Swede-maker/paternoster-filament-storage/pi-agent/paternoster_agent.py

#!/usr/bin/env python3
"""
PAX paternoster — Raspberry Pi GPIO agent.

This program runs ON a Raspberry Pi and drives one paternoster carousel (or a
Left and a Right carousel in twin mode). A carousel is driven by:
  * EITHER one brushed DC motor on a BTS7960 / IBT-2 half-bridge with PWM
    speed control ("dc" drive mode, the default; a timed jog in MILLISECONDS
    nudges the carousel by hand; the second bridge is only used by the Right
    carousel of a twin setup),
  * OR two StepperOnline iSV57T integrated servos on pulse/direction lines,
    one per chain ("servo" drive mode: synchronised dual-motor moves, speed by
    pulse frequency, exact-count micro-jog per motor in PULSES), and
  * two inductive proximity sensors (identical in both modes):
      - SHELF sensor: pulses once as every shelf passes the pick window,
      - INDEX sensor: active only at shelf 1 (the home / absolute reference).

The drive mode is chosen in the web app (setup wizard / Settings) and pushed in
`config.motorMode`; the agent persists it in MOTOR_CONF_PATH and initialises
the matching backend on boot. `--motor dc|servo` overrides it.

It exposes a WebSocket server that the PAX web app connects to. The wire format
matches `lib/node-protocol.ts` in the web app exactly:

  app  -> pi : {"type":"home"} | {"type":"goto","shelf":N} | {"type":"stop"}
               | {"type":"config","shelves":N,"motorMode":"dc|servo",...}
               | {"type":"jog","motor":"a|b|both","direction":"up|down",
                  "pulses":N}            (servo: exact pulse count)
                  "ms":N,"speed":0..1}   (dc: run time in milliseconds)
               | {"type":"release"} | {"type":"hold"}   (servo: free / re-energise)
               | {"type":"hello"}
  pi   -> app: {"type":"hello",...,"motorMode":"dc|servo"} | {"type":"state",...}
               | {"type":"pos","shelf":N} | {"type":"arrived","shelf":N}
               | {"type":"homed","shelf":N} | {"type":"fault","message":"..."}
               | {"type":"servo","mode":"dc|servo","alarmA":bool,"alarmB":bool,
                  "held":bool,"holdTimeoutS":N,...}
                 (drive status; in dc mode the alarm/hold fields are absent)

Shelf indexes are 0-based on the wire (shelf 0 == the INDEX sensor position).

Run on the Pi:
    python3 paternoster_agent.py --name "Paternoster 1" --shelves 9

Test on a laptop (no GPIO hardware needed) with the built-in simulator:
    python3 paternoster_agent.py --simulate --shelves 9
"""

import argparse
import asyncio
import json
import math
import os
import select
import socket
import threading
import time
import traceback
import weakref
from typing import Callable, Optional, Tuple

# Wi-Fi / hotspot management (NetworkManager). Optional: the agent must keep
# driving the motor even if paxnet.py is missing or nmcli is not installed —
# the `net.*` commands then answer with a clear error instead of crashing.
try:
    if __import__("sys").platform == "win32":
        import paxnet_win as paxnet  # noqa: E402  (Windows PC master)
    else:
        import paxnet  # noqa: E402
except Exception as _paxnet_exc:  # pragma: no cover
    paxnet = None
    _PAXNET_IMPORT_ERROR = repr(_paxnet_exc)
else:
    _PAXNET_IMPORT_ERROR = None

# --------------------------------------------------------------------------
# Pin configuration (BCM numbering). Adjust to match your wiring.
# --------------------------------------------------------------------------
# DC drive mode: ONE BTS7960 / IBT-2 43A half-bridge per carousel. Unlike an
# L298N there is no single "enable = PWM" pin: RPWM and LPWM are BOTH PWM
# inputs and *which one* you drive picks the direction. Drive only one at a
# time — driving both together shoots through the bridge.
#
# A single carousel uses bridge A. Bridge B is only used by a twin setup, where
# one Pi drives a Left carousel (motor A) and a Right carousel (motor B), each
# with its own sensors. Two DC motors on the SAME carousel are not supported.
PIN_MOTOR_A_RPWM = 12  # bridge A -> RPWM (PWM, drives one direction)
PIN_MOTOR_A_LPWM = 13  # bridge A -> LPWM (PWM, drives the other direction)
PIN_MOTOR_A_EN = 22    # bridge A -> R_EN + L_EN tied together (HIGH = armed)
PIN_MOTOR_B_RPWM = 20  # bridge B -> RPWM
PIN_MOTOR_B_LPWM = 21  # bridge B -> LPWM
PIN_MOTOR_B_EN = 27    # bridge B -> R_EN + L_EN tied together
# Backwards-compatible aliases (motor_test.py and older notes refer to these).
PIN_MOTOR_RPWM = PIN_MOTOR_A_RPWM
PIN_MOTOR_LPWM = PIN_MOTOR_A_LPWM
PIN_MOTOR_EN = PIN_MOTOR_A_EN
# Kept for the `servo` status snapshot: the "Mirror motor B" switch is shared
# with the servo backend, where it still matters. The DC backend drives one
# motor and does not use it.
DC_MIRROR_B = True
# Timed jog on a DC bridge. There is no step unit, so a jog is "run the motor
# for N milliseconds" at a fixed duty; the app's step size is in ms. The duty
# defaults to the same cruise duty as a move so the motor reliably breaks
# stiction; the app may pass its own `speed`.
DC_JOG_DUTY = 0.45
DC_JOG_MAX_MS = 5000
# Time slice used to poll for an estop while a timed jog runs.
DC_JOG_SLICE_S = 0.01
# Inductive sensor. This is a LEVEL, not a pulse: it stays active for as long as
# a shelf's metal flag is in front of it, and a parked carousel is ALWAYS sitting
# with a flag in the window. So the sensor reads active before a move even starts,
# and that standing signal is not a shelf that has been passed.
#
# Shelves are therefore counted as TRANSITIONS — the flag leaves the window, the
# next flag enters it — never as "one pulse per shelf". Treating the level as a
# pulse is what made a move of N shelves finish after N-1.
PIN_SHELF_SENSOR = 23
PIN_INDEX_SENSOR = 24  # inductive sensor: active only at shelf 1 (home)
# Twin carousels (hardware only): two independent carousels on one Pi. The LEFT
# one uses motor A and the sensors above; the RIGHT one uses motor B and its own
# shelf + home sensors on these pins (wired exactly like 23/24).
PIN_SHELF_SENSOR_R = 19
PIN_INDEX_SENSOR_R = 4
TWIN_SIDES = ("left", "right")

# --------------------------------------------------------------------------
# Servo drive mode: two StepperOnline iSV57T integrated servos on PUL/DIR.
#
# Selected per unit from the app (setup wizard / Settings → "Motor drive") and
# remembered in MOTOR_CONF_PATH so the right backend comes up on the next boot.
# The sensors are identical in both modes; only the motor pins differ.
#
# PUL on GPIO12 / GPIO13: these are the Pi's two hardware-PWM channels, so the
# pulse train is generated by the PWM peripheral and not by a Python loop —
# jitter-free at any frequency the drive accepts. Motor A and motor B get their
# own channel so they can also be jogged INDIVIDUALLY for chain alignment; for
# a move both channels run the same frequency and direction.
#
# The iSV57T opto inputs want 4–5 V at 7–16 mA (manual §3). A Pi GPIO is 3.3 V
# and is only rated for a few mA, so drive PUL/DIR through a 5 V line driver
# (74AHCT125 / 74HCT245) — see README "Servo wiring". ALM is an open-collector
# output: wire ALM- to GND and ALM+ to the GPIO; the Pi's pull-up reads LOW in
# normal operation and HIGH when the drive trips (over-current / over-voltage /
# position-following error).
# --------------------------------------------------------------------------
PIN_SERVO_PUL_A = 12
PIN_SERVO_PUL_B = 13
PIN_SERVO_DIR_A = 5
PIN_SERVO_DIR_B = 6
PIN_SERVO_ALM_A = 16
PIN_SERVO_ALM_B = 26
# "Release" outputs. The iSV57T has NO enable (ENA) input — its control
# connector is only PUL/DIR/ALM — so a parked servo always holds with full
# torque and cannot be turned by hand while powered. The only way to let go is
# to cut the drive's 24–36 V supply. Wire each output to a relay / high-side
# MOSFET module in the +Vdc lead of the matching drive (or tie both outputs to
# one relay that feeds both drives). The agent opens the relay after the idle
# timeout or on request and closes it again before the next move or jog.
# Leave the outputs unconnected if you do not want this; nothing else changes.
PIN_SERVO_ENA_A = 17
PIN_SERVO_ENA_B = 25
# True: GPIO HIGH = relay open = motor free. Set False for a relay module that
# is active-low (most cheap opto relay boards: IN pulled LOW closes the relay).
SERVO_ENA_ACTIVE_RELEASES = True
# Time for the drive to boot after its supply returns before the first pulse
# edge arrives. The iSV57T needs ~1 s after power-up; the step pulses sent
# before that are lost.
SERVO_ENABLE_SETTLE_S = 1.2
# Drives with a real enable input (closed-loop stepper MF, AC servo S-ON) stay
# powered while released, so re-engaging only waits for the coils / servo loop
# to lock, not for a boot.
SERVO_ENA_INPUT_SETTLE_S = 0.3
# Highest pulse rate the Pi header can produce. gpiozero's lgpio pin factory
# (the default on Bookworm / Pi 5) times PWM in software and refuses
# frequencies above 10 kHz. At 800 pulses/rev that is still 750 rpm at the
# motor shaft. The ESP32 controller (hardware LEDC timer) is not capped by this.
SERVO_GPIO_MAX_PPS = 10_000
# Idle seconds before the servos are released automatically. 0 = never release
# (hold with full torque). Defaults to 0 because release only does something
# with the optional supply relay wired. The app overrides this per unit via
# `config.servoHoldTimeoutS`.
SERVO_HOLD_TIMEOUT_S = 0
# Upper bound for the operator's "safe move time" (config.sensorArmS): how long
# after a move or homing run starts the sensors are ignored. 0 = off (default).
SENSOR_ARM_MAX_S = 10.0

# Pulses per motor revolution. Must equal the drive's DIP S1–S3 setting (or
# Pr0.08 when S1–S3 are all OFF). Factory default is 4000 → 0.09° per pulse.
SERVO_PULSES_PER_REV = 4000
# Pulse frequency at 100 % speed. The drive accepts up to 300 kHz, but a
# geared carousel does not need anything close to that: 8 000 pps at 4000 ppr is
# 120 rpm at the motor shaft. The app's "Motor speed" slider scales 0..1 of this.
SERVO_MAX_PPS = 8000
# Lowest frequency the slider floor maps to; below this the carousel just
# twitches between pulses.
SERVO_MIN_PPS = 200
# Idle frequency programmed into the PWM channel while it is switched off.
SERVO_IDLE_HZ = 1000
# Micro-jog pulse rate. Deliberately slow (bit-banged, exact pulse count) so a
# jog of N pulses moves exactly N pulses — this is an ALIGNMENT tool.
SERVO_JOG_PPS = 800
SERVO_JOG_MAX_PULSES = 20000
# Manual §3: DIR must be stable at least 5 µs before the first PUL edge. Python
# cannot sleep 5 µs reliably, so wait 1 ms — invisible to the operator.
SERVO_DIR_SETUP_S = 0.001
# Motor B faces the other way on most dual-chain builds, so its DIR is inverted
# for the two to pull the same way. Flip from the app if yours is wired alike.
SERVO_MIRROR_B = True

# Which drive sits on the PUL/DIR lines. The motion code is identical for all
# three; the profile only decides the polarity of the enable and alarm lines,
# the pulse ceiling and the default pulse source. Mirrors PULSE_DRIVE_PROFILES
# in lib/filament.ts — keep the two in step.
#   ena_active_low : GPIO LOW on the enable output = motor ENGAGED. False
#                    (HIGH = engaged) covers both README hookups: S-ON through
#                    an NPN transistor (HIGH on the base = S-ON conducting =
#                    servo on) and the stepper's MF wired common-anode (+5 V
#                    on MF+, GPIO sinks MF-: LOW = MF conducting = coils OFF,
#                    HIGH = engaged). Flip it from the app if your hookup
#                    inverts one of these (e.g. MF through the transistor).
#   alm_active_low : the ALM optocoupler CONDUCTS (pin LOW) on a fault. iSV57T
#                    and A6-RS conduct while healthy (False); CL86Y conducts
#                    on the alarm (True).
#   has_enable     : the drive has an enable / motor-free input. The iSV57T has
#                    none, so its "release" is the optional supply relay.
PULSE_DRIVE_DEFAULT = "integrated-servo"
PULSE_DRIVES = ("integrated-servo", "ac-servo", "closed-loop-stepper")
PULSE_DRIVE_PROFILES = {
    "integrated-servo":   {"ena_active_low": False, "alm_active_low": False, "max_pps": 300_000, "has_enable": False, "default_driver": "esp32"},
    "ac-servo":           {"ena_active_low": False, "alm_active_low": False, "max_pps": 300_000, "has_enable": True,  "default_driver": "esp32"},
    "closed-loop-stepper":{"ena_active_low": False, "alm_active_low": True,  "max_pps": 200_000, "has_enable": True,  "default_driver": "esp32"},
}


def pulse_drive_profile(drive: Optional[str]) -> dict:
    return PULSE_DRIVE_PROFILES.get(drive if drive in PULSE_DRIVES else PULSE_DRIVE_DEFAULT)

# ESP32 servo controller (pi-agent/esp32-servo). With servoDriver = "esp32" the
# Pi no longer pulses PUL/DIR itself: it sends RUN/STOP/JOG lines to the ESP32
# over a serial link and receives sensor edges and drive status back. The
# sensors move to the ESP32 too, so the stop on a flag never waits for Linux.
#   link "usb"  : the DevKit's micro-USB (CP2102/CH340 -> /dev/ttyUSB0, or
#                 native USB -> /dev/ttyACM0); auto-detected via /dev/serial/by-id.
#   link "uart" : 3 wires on the Pi header (GPIO14 TXD -> ESP32 RX 21,
#                 GPIO15 RXD <- ESP32 TX 22, GND); needs the serial console
#                 disabled (install.sh --esp32-uart does this).
#   link "wifi" : no Pi on that carousel at all. The board runs standalone,
#                 joins the router (or the master's hotspot as a fallback) and
#                 serves the same line protocol on TCP port 8766. This agent
#                 instance is then just the brain for a remote board — run it
#                 on the master Pi as a second service (install.sh --instance).
ESP32_LINK_DEFAULT = "usb"
ESP32_LINKS = ("usb", "uart", "wifi")
ESP32_UART_PORT = "/dev/serial0"
ESP32_USB_CANDIDATES = ("/dev/ttyUSB0", "/dev/ttyACM0", "/dev/ttyUSB1", "/dev/ttyACM1")
ESP32_BAUD_DEFAULT = 460800
ESP32_WIFI_PORT = 8766
ESP32_PING_S = 0.5             # keep-alive; the firmware stops after 1.5 s of silence
ESP32_STATUS_TIMEOUT_S = 1.5   # no status line for this long = link down
ESP32_WIFI_STATUS_TIMEOUT_S = 3.0   # Wi-Fi jitter: give it twice as long (firmware wd_ms matches)
ESP32_RECONNECT_S = 2.0
ESP32_READ_GLITCH_LIMIT = 50   # consecutive empty-read errors (~0.5 s) before the link counts as lost
ESP32_HELLO_TIMEOUT_S = 4.0    # opening a USB port resets the board; it reboots in ~1 s
ESP32_WIFI_CONNECT_TIMEOUT_S = 3.0

# Where the agent remembers the selected drive mode and servo parameters between
# restarts. Written whenever the app pushes a `config` with motor fields.
# A second agent instance on the same Pi (a Wi-Fi ESP32 carousel) gets its own
# file via PAX_MOTOR_CONF / --motor-conf so the two never overwrite each other.
MOTOR_CONF_PATH = os.environ.get("PAX_MOTOR_CONF") or "/var/lib/pax-agent/motor.json"

# Motion tuning. These are DEFAULTS ONLY — the app overrides them at runtime via
# the `config` command, so the speed and soft-start sliders reach the motor. Do
# not read these constants inside motion code; read the Carousel instance fields
# (self.move_speed / self.ramp_pct) or slider changes will silently do nothing.
HOMING_SPEED = 0.35   # 0..1 PWM duty during homing
MOVE_SPEED = 0.45     # 0..1 PWM duty during normal moves
# A BTS7960 with a geared carousel will not break stiction much below this duty;
# it just buzzes and heats. Speed requests are clamped up to this floor.
MIN_DUTY = 0.25
# Floor for an OPERATOR-supplied duty from the app's PWM slider. Much lower than
# MIN_DUTY on purpose: MIN_DUTY protects the agent's own crawls, where a stalled
# motor would break shelf counting, but clamping the slider to it silently
# discarded any lower request and made the control appear dead. Stiction varies
# per machine, so the operator is trusted to find the usable range.
SLIDER_MIN_DUTY = 0.05
# Soft start/stop: seconds spent ramping at 100% ramp intensity. The ramp is
# applied in small PWM steps while the motor is already powered.
MAX_RAMP_SECONDS = 1.2
RAMP_STEP_SECONDS = 0.02  # PWM update interval while ramping
# Hard ceiling on the soft STOP once the target shelf's pulse has been counted.
# Every millisecond of deceleration is extra travel PAST the shelf we were asked
# to stop at, so a full MAX_RAMP_SECONDS soft stop could coast the better part of
# a whole shelf beyond the target. Softness after the target is worth far less
# than stopping where the user asked, so the stop ramp gets its own short budget.
STOP_RAMP_SECONDS = 0.25
# Fraction of the last measured shelf-to-shelf interval that the smooth
# deceleration on the final approach is allowed to occupy. The decel ramp runs
# BEFORE the target flag is detected, across the pitch that already exists
# between the penultimate shelf and the target, so it never adds overshoot — but
# it MUST finish before the flag arrives or the carousel would still be fast at
# the stop. Sizing it to a fraction of the observed pitch guarantees that: the
# final leg starts at cruise and then slows, so it always lasts longer than the
# cruise-speed pitch this fraction is taken from.
DECEL_LEG_FRACTION = 0.6
PULSE_TIMEOUT = 8.0   # seconds to wait for the next shelf pulse before faulting
HOME_TIMEOUT = 30.0   # default seconds to find the index sensor before faulting
# The servo build turns the carousel through a 1:50 gearbox and is a good deal
# slower between flags than the DC build these timeouts were tuned on, so give
# it twice as long before calling a move or a homing run stuck. DC keeps 1x.
SERVO_TIMEOUT_SCALE = 2.0
# The operator can override the homing time per carousel from Settings →
# Motor drive → "Homing time" (config.homeTimeoutS). The drive default is
# HOME_TIMEOUT × the scale above (30 s DC / 60 s servo). Bounds below.
HOME_TIMEOUT_MIN_S = 5.0
HOME_TIMEOUT_MAX_S = 600.0
# Motor drive → "Shelf timeout" (config.shelfTimeoutS). Replaces the
# PULSE_TIMEOUT × drive-scale base of the move's jam guard; speed scaling, ramp
# and Safe move time are still added on top.
SHELF_TIMEOUT_MIN_S = 2.0
SHELF_TIMEOUT_MAX_S = 300.0
# How often a long sensor wait re-checks for an emergency stop. Small enough to
# feel instant to an operator, large enough not to spin the CPU.
ABORT_POLL_SECONDS = 0.02
SENSOR_BOUNCE = 0.01  # debounce (s) for the inductive sensors
# How often the sensor-watch thread samples the shelf sensor's logical level to
# report it to the app. This drives only the UI status lamp — NOT shelf counting
# (that is edge-driven in the motion code) — so a light 20 Hz poll is plenty
# responsive without loading the CPU or perturbing the timing-critical counting.
SENSOR_POLL_SECONDS = 0.05
# ---------------------------------------------------------------------------
# Mechanical shelf-bounce filter.
#
# A shelf can swing/rock as it settles, leaving the sensor window and swinging
# straight back into it. Each re-entry is a fresh rising edge, so the SAME shelf
# was counted twice or more and the carousel believed it had travelled further
# than it had.
#
# The filter is a LOCKOUT APPLIED AFTER a counted shelf: once a shelf is counted,
# further rising edges are ignored for a short period, which is exactly how long
# that shelf's own rocking lasts. The next genuine shelf arrives well after the
# lockout, so it counts.
#
# The direction of the test matters more than its length. An earlier version was
# release-based — an edge only counted once the window had been EMPTY for a while
# first — and that is a precondition IN FRONT OF the stop signal, so the filter
# could delay or drop the very edge that must cut power. It did exactly that on
# every move (see _on_shelf). A lockout can only ever ignore a LATER edge, so the
# rising edge that stops the carousel is always published instantly.
#
# The period is NOT a fixed wall-clock value, because the safe ceiling depends on
# speed. Per-shelf travel is ~0.5s at MOVE_SPEED, so a flat 1.0-1.5s lockout would
# outlast the gap between shelves and swallow genuine ones. Scaling with duty
# keeps it a constant fraction of the real shelf spacing at every speed.
#
# This filters COUNTING only. It never gates motor power, and position still
# comes from counted pulses rather than from elapsed time.
SHELF_SETTLE_AT_MOVE_SPEED = 0.20
SHELF_SETTLE_MAX = 1.5
# ---------------------------------------------------------------------------
# Distance-based shelf-edge filter (Carousel._do_goto).
#
# The time lockout above only knows "how long ago"; it cannot tell a slow swing
# from a slow shelf. A DISTANCE test can. On the servo build the pulse odometer
# says exactly how far the chain has moved since the last counted edge, so an
# edge that arrives inside BOUNCE_PITCH_FRACTION of a shelf pitch is the same
# shelf rocking back into the window, never the next one — regardless of ramp or
# speed. The DC build has no odometer, so it falls back to the same test in TIME,
# against the pitch interval just measured in this move (BOUNCE_TIME_FRACTION,
# deliberately looser because the first interval of a move includes the ramp).
BOUNCE_PITCH_FRACTION = 0.5
BOUNCE_TIME_FRACTION = 0.35
# The FIRST edge of a move. A stop that lands exactly as the flag reaches the
# sensor can leave the shelf a hair short of the window, or rocking back out of
# it; the next move then drags that same flag in and the carousel believes it
# gained a shelf it never travelled. Any edge within this fraction of a pitch of
# the starting point is that parked shelf, not a new one.
START_REENTRY_PITCH_FRACTION = 0.3
# Pulse positioning (servo): deceleration leg before the target as a fraction of
# a shelf pitch, and how often the duty is re-issued along it.
PULSE_DECEL_PITCH_FRACTION = 0.5
PULSE_DUTY_UPDATE_S = 0.02
# The calibration revolution may take a while on a slow chain: allowance for the
# full turn, as a multiple of HOME_TIMEOUT (already drive-scaled).
CALIBRATE_TIMEOUT_SCALE = 3.0
# The index sensor must stay clear this long before the flag counts as passed
# (flag-length measurement), so a flickering edge is not taken for its end.
FLAG_CLEAR_CONFIRM_S = 0.005
# Pause after the second flag pass before reversing onto the flag's middle.
CALIBRATE_REVERSE_SETTLE_S = 0.3


def shelf_settle_for(duty: float) -> float:
    """
    Post-trigger bounce lockout for a given PWM duty.

    Travel time per shelf is inversely proportional to duty, so the lockout scales
    the same way and stays at a constant FRACTION of the real shelf spacing. That
    is what makes one setting correct at 45% and at 5% alike. Capped so a
    near-stalled duty cannot produce an absurdly long blind window.
    """
    lockout = SHELF_SETTLE_AT_MOVE_SPEED * (MOVE_SPEED / max(0.01, duty))
    return min(SHELF_SETTLE_MAX, lockout)


# Travel time for ONE shelf pitch at MOVE_SPEED. Not used to decide position --
# the sensor always does that -- only to say how EARLY an edge has to be before it
# is physically impossible for it to be the next shelf.
SHELF_TRAVEL_AT_MOVE_SPEED = 0.5

# Fraction of a shelf pitch that two accepted shelf counts must be separated by.
#
# The chain can only rock by its own backlash, a fixed mechanical property well
# under one shelf spacing. An edge that appears after less travel than this cannot
# be a new shelf, because the next shelf is a WHOLE pitch away. Kept below 0.5 so
# the rule can never reach halfway to a genuine shelf: if a machine ever has more
# slack than this the cure is to tension the chain, not to widen the window, and
# widening it past 0.5 would start swallowing real shelves.
DEPARTURE_SLACK_FRACTION = 0.45


def min_shelf_gap_for(duty: float) -> float:
    """
    The shortest time in which the carousel could genuinely reach the NEXT shelf.

    Anything sooner is mechanical -- chain slack, a lurch, a flag rocking back
    across the sensor -- and must not be counted. Used ONLY to reject the
    physically impossible, never to decide where the carousel is; the sensor
    always does that.

    Scaled by duty because travel time per pitch is inversely proportional to it,
    so the window stays the same fraction of the real shelf SPACING at every
    speed. That is what makes one constant correct at 45% duty and at 5% alike.

    Two things a single sensor cannot distinguish by level alone, both of which
    produce a real rising edge and both of which were being counted as shelves:

      - THE START OF A MOVE. The carousel is parked on a flag, so energising the
        motor takes up slack: the flag drops back out of the window and is then
        pulled forwards into it again.
      - THE ARRIVAL CHANGEOVER. At one shelf short of target the duty drops to
        the arrival value, and that sudden torque change lets the chain lurch,
        which can carry the shelf just counted back across the sensor.

    Distance travelled is the one thing that separates those from a real shelf.
    """
    pitch = SHELF_TRAVEL_AT_MOVE_SPEED * (MOVE_SPEED / max(0.01, duty))
    return min(SHELF_SETTLE_MAX, DEPARTURE_SLACK_FRACTION * pitch)
# Max time to drive off the index flag when homing starts while already on it.
# The motor runs throughout; this only bounds how long we watch for it to clear.
INDEX_CLEAR_TIMEOUT = 10.0
# Fallback blanking for the rare case where a move STARTS with the shelf window
# already empty (an aborted move, or a fault that left the carousel mid-travel).
# In the normal case the flag is sitting in the window and the far more accurate
# `shelf_clear()` wait below is used instead of this fixed guess.
# The motor runs normally during this window: it filters counting, not power.
# Keep it well under the real per-shelf travel time (~0.5s at MOVE_SPEED).
PULSE_BLANKING = 0.15
# How long to wait for the parked flag to slide back INTO the window when a move
# reverses out of an empty window. Only needs to cover the small overshoot the
# previous stop coasted past the sensor, so it is short. If it expires the flag
# was never there (the machine was left mid-travel), and counting simply starts
# with the next real shelf.
REVERSE_REENTRY_TIMEOUT = 1.5

# ---- Parking ON the sensor -----------------------------------------------
# The carousel parks with the target shelf's flag still INSIDE the sensor
# window, so "in position" is a fact that can be re-checked at any time rather
# than dead reckoning. Two consequences drive the motion code:
#   * A move BEGINS with the sensor already active. The flag must be driven out
#     of the window before counting starts, or the level dropping as it leaves
#     (or a bounce right on the boundary) is counted as the target's arrival and
#     the move ends after ~30mm.
#   * A move must END inside the window. A soft stop always coasts, so after
#     stopping the sensor is re-checked and the shelf is crept back into the
#     window if it drifted out.
# Bounds how long we watch the parked flag leave the window. The motor runs
# throughout; this only limits the wait, exactly like INDEX_CLEAR_TIMEOUT.
SHELF_CLEAR_TIMEOUT = 10.0
# Realignment crawl. MIN_DUTY is the slowest duty that still breaks stiction,
# which is precisely what "go even more slow in reverse" needs.
CREEP_DUTY = MIN_DUTY
CREEP_TIMEOUT = 6.0
# The crawl is PULSED, not continuous: drive for CREEP_PULSE_ON, cut power, let
# it settle for CREEP_PULSE_OFF, then read the sensor. A continuous crawl cannot
# be stopped inside a narrow window — by the time the level is read and `stop()`
# lands, the flag has already coasted out the far side, so the correction
# overshoots in the new direction and the carousel oscillates on one shelf
# forever. Pulsing bounds how far a single step can travel and guarantees the
# sensor is read while the motor is genuinely stopped.
CREEP_PULSE_ON = 0.04
CREEP_PULSE_OFF = 0.05
# How long to wait after cutting power before trusting a sensor reading. Cutting
# power does not stop a loaded carousel; it coasts. Raise this if the machine is
# heavy and alignment decisions still seem to be made on a moving flag.
MOTION_SETTLE = 0.20
# How many verify-and-correct rounds to attempt before declaring the position
# unknown. Bounded on purpose: if the carousel coasts further than the sensor
# window is wide, no amount of retrying can park inside it, and looping forever
# is exactly the "spins back and forth on one shelf" failure. Better to stop and
# ask for a re-home.
SETTLE_ATTEMPTS = 4
# Longest we will wait for a coast to finish before calling the position
# unknown. Must exceed the machine's real coast-down time; a carousel that
# genuinely cannot hold the sensor within this window needs mechanical
# attention (or a lower move speed), not a longer timeout.
COAST_MAX = 3.0
# How long the sensor level must stay unchanged before the carousel is believed
# to be at rest. This must be LONGER than the slowest credible crossing of the
# sensor window, because a machine drifting through the window also holds the
# level steady — just not for long. Too small and a slow coast reads as a park
# (the flag then drifts out and the position silently goes wrong); too large and
# every move pays the wait. It only needs to exceed window_width / creep_speed.
REST_STABLE = 0.9
# Hard cap on ONE correction attempt. Realignment only ever recovers a flag we
# just coasted past, so it should need a fraction of a shelf. Bounding it stops a
# failed correction from turning into an open-ended hunt that parks on a
# different shelf than the one being reported.
CREEP_BUDGET = 1.5
# Hard cap on how many creep pulses one recovery may use. This is the distance
# bound that keeps alignment honest: a recovery that crawls far enough will
# eventually reach the NEXT shelf's flag, pass the "on a flag" test, and report
# the wrong shelf as correct. Sized so the total crawl stays well under one
# shelf pitch. Lower it if a failed alignment ever ends up a shelf out.
CREEP_MAX_PULSES = 12
# Total sensor edges the ENTIRE alignment may pass, across all retries. A single
# attempt being bounded is not enough — several bounded attempts still add up to
# a different shelf. Two is the honest limit: leaving the flag we overshot and
# re-entering it. A third edge means we have entered a DIFFERENT window, and
# anything found there is a different shelf no matter how well centred it is.
SETTLE_MAX_EDGES = 2
# SIMULATION ONLY. Half-width of the sensor window in shelf units, i.e. how much
# of the travel between two shelves reads "detected". A ~35mm flag on a ~200mm
# shelf pitch is about 0.18. Without a window the simulated sensor is a zero-
# width tripwire that is never active while parked, which cannot reproduce any
# of the park-on-sensor behaviour this code exists to get right.
SIM_SENSOR_HALF_WIDTH = 0.18

# Output type of the inductive proximity sensors. This decides which logic level
# counts as "shelf detected", so getting it wrong makes the sensors look dead and
# homing fails with "index sensor not found".
#
#   "NPN" (sinking, active-LOW)  - output floats when idle and pulls to GND when
#                                  triggered. Needs a pull-UP so the pin idles
#                                  high. This is the safe choice for a Pi: the
#                                  signal line only ever sees 3.3 V (from the
#                                  pull-up) or GND, never the sensor's 12/24 V.
#   "PNP" (sourcing, active-HIGH) - output floats when idle and sources +V when
#                                  triggered. Needs a pull-DOWN, AND a level
#                                  shifter/divider, because a 12/24 V sensor
#                                  would otherwise feed 12/24 V straight into a
#                                  3.3 V GPIO and destroy the Pi.
SENSOR_TYPE = "NPN"

# Invert what the sensor signal MEANS, without touching how it is wired.
#
# True  -> a shelf is present when the sensor reads INACTIVE (signal absent).
# False -> a shelf is present when the sensor reads ACTIVE (signal present).
#
# Set this, not SENSOR_TYPE, to fix "it counts in the gaps instead of on the
# shelves". SENSOR_TYPE controls the pull resistor, which is an ELECTRICAL
# property: changing it to flip the logic would leave an NPN line floating, and
# a real PNP sensor needs a level shifter first or it puts 12/24 V into a 3.3 V
# GPIO. This flag is pure logic and is always safe to change.
#
# Use True for a normally-closed sensor, or when the flags are cut as NOTCHES in
# an otherwise continuous ring rather than as tabs — in both cases the signal is
# present everywhere EXCEPT at a shelf, so every edge and level below has to be
# read the other way round.
SENSOR_INVERT = True

# Which way the motor turns for "up" (decreasing shelf index). Flip if your
# carousel runs backwards relative to the app's direction labels.
HOMING_DIRECTION = "down"


def home_travel_direction() -> str:
    """The carousel direction ("up"/"down") the homing sweep runs in."""
    return "up" if HOMING_DIRECTION == "down" else "down"


# ==========================================================================
# Persisted motor-drive selection
# ==========================================================================
def load_motor_conf() -> dict:
    """Read the drive mode + servo tuning saved by a previous `config`."""
    try:
        with open(MOTOR_CONF_PATH, "r", encoding="utf-8") as fh:
            data = json.load(fh)
        return data if isinstance(data, dict) else {}
    except FileNotFoundError:
        return {}
    except Exception as exc:
        print(f"[agent] motor.json unreadable ({exc}); using defaults", flush=True)
        return {}


def save_motor_conf(conf: dict) -> None:
    """
    Persist the drive mode so the next boot initialises the right backend
    before the app has even connected. Best-effort: a read-only filesystem must
    not take the motor down, it just means the mode is re-applied on connect.
    """
    try:
        import os

        os.makedirs(os.path.dirname(MOTOR_CONF_PATH), exist_ok=True)
        tmp = MOTOR_CONF_PATH + ".tmp"
        with open(tmp, "w", encoding="utf-8") as fh:
            json.dump(conf, fh)
        os.replace(tmp, MOTOR_CONF_PATH)
    except Exception as exc:
        print(f"[agent] could not persist motor config ({exc}); will re-apply on next connect", flush=True)


# ==========================================================================
# Hardware backends
# ==========================================================================
def _present(devices) -> tuple:
    """GPIO devices that exist (twin mode leaves the other side's channel None)."""
    return tuple(d for d in devices if d is not None)


class RealHardware:
    """
    Drives real GPIO through gpiozero: ONE DC motor on a BTS7960 bridge plus
    the two inductive sensors. A carousel is driven by a single DC motor; the
    second bridge (motor B) exists only so a twin setup can run a Left and a
    Right carousel from the same Pi, each with its own backend instance.

    The motor half lives in `_init_motor` / `forward` / `backward` / `stop` /
    `_close_motor` / `jog` so `ServoHardware` can swap in PUL/DIR control while
    reusing every sensor-counting detail below unchanged. The motion code only
    ever calls `forward`/`backward`/`stop` with a 0..1 "speed", which the DC
    bridge turns into a PWM duty and a servo drive turns into a pulse frequency.
    """

    motor_mode = "dc"

    def __init__(
        self,
        mirror_b: Optional[bool] = None,
        motor_index: Optional[int] = None,
        shelf_pin: int = PIN_SHELF_SENSOR,
        index_pin: int = PIN_INDEX_SENSOR,
    ) -> None:
        if mirror_b is not None:
            self.mirror_b = bool(mirror_b)
        # Which bridge this carousel's motor is on: 0 = A (default, single
        # carousel or the twin Left side), 1 = B (twin Right side). Only that
        # motor's pins are claimed, so a second backend can own the other one.
        self.motor_index = motor_index if motor_index in (0, 1) else None
        # Run this carousel's motor the other way round.
        self.reverse = False
        self._init_motor()
        self._init_sensor_state()
        self._init_sensors(shelf_pin, index_pin)

    def _init_sensors(self, shelf_pin: int, index_pin: int) -> None:
        """Claim the two sensor GPIOs and route their edges into the counters."""
        from gpiozero import DigitalInputDevice  # imported lazily

        # An NPN (sinking) sensor pulls the line to GND when it detects a shelf,
        # so we pull the pin up and let gpiozero treat LOW as active. A PNP
        # (sourcing) sensor is the mirror image: pull down, HIGH is active.
        # gpiozero derives `is_active` from pull_up, so the rest of this class
        # stays level-agnostic and only this flag has to change.
        pull_up = SENSOR_TYPE.upper() == "NPN"
        self.shelf = DigitalInputDevice(shelf_pin, pull_up=pull_up, bounce_time=SENSOR_BOUNCE)
        self.index = DigitalInputDevice(index_pin, pull_up=pull_up, bounce_time=SENSOR_BOUNCE)
        # WHICH EDGE MEANS "METAL ARRIVED" depends on SENSOR_INVERT.
        #
        # gpiozero names these after the electrical level, not after the shelf. On
        # an inverted sensor the signal is present in the GAPS, so metal arriving
        # DEACTIVATES the input and `when_deactivated` is the arrival edge. Leaving
        # these unswapped is what makes the carousel count in the gaps and stop
        # between shelves — the count would be off by exactly half a pitch.
        if SENSOR_INVERT:
            self.shelf.when_deactivated = self._on_shelf
            self.index.when_deactivated = self._on_index
        else:
            self.shelf.when_activated = self._on_shelf
            self.index.when_activated = self._on_index
        # The exit edge is the opposite one, mirrored the same way — otherwise it
        # would be bound to the same edge as the arrival above and every arrival
        # would immediately register as a departure.
        if SENSOR_INVERT:
            self.shelf.when_activated = self._on_shelf_exit
        else:
            self.shelf.when_deactivated = self._on_shelf_exit

    def _init_sensor_state(self) -> None:
        """Counters, lockout and direction memory shared by every sensor source."""
        # ------------------------------------------------------------------
        # Sensors are EDGE COUNTERS, never a power gate.
        #
        # This class used to answer "has a shelf passed?" with gpiozero's
        # `wait_for_active()`, which returns instantly when the sensor is
        # ALREADY active. A parked carousel sits with a shelf right in the
        # sensor window, so every such call returned True immediately, the
        # move loop burned through all its steps in microseconds, and the
        # motor was switched off again before it could physically turn. The
        # observable result was a motor that only twitched, and that appeared
        # to run only while a sensor saw something.
        #
        # `when_activated` fires ONLY on a real inactive->active transition, so
        # a sensor that is already covered contributes no count at all. Counts
        # accumulate in the background completely independently of motor power:
        # the motion code starts the motor, then consumes counts as they
        # arrive. Sensor LEVEL never decides whether the motor is energised.
        # ------------------------------------------------------------------
        self._lock = threading.Lock()
        self._shelf_pulses = 0
        self._index_pulses = 0
        self._shelf_tick = threading.Event()
        self._index_tick = threading.Event()
        # Mechanical bounce filter state: the time the last shelf was COUNTED.
        # `None` means "no recent count", so the next rising edge passes straight
        # through. See _on_shelf for why this is a lockout AFTER a trigger and
        # never a wait BEFORE one.
        self._last_counted: Optional[float] = None
        self._shelf_settle = 0.0
        self._suppressed_bounces = 0

        # Which way the motor is turning right now, and which way it was turning
        # at the moment the shelf flag LEFT the sensor window.
        #
        # The second is the only reliable answer to "which side of the sensor is
        # the flag parked on", and that is what decides whether the next move
        # will drag it back through. It has to be MEASURED, not inferred from the
        # move direction: depending on how hard the machine brakes, a move can
        # end just PAST the flag (heavy carousel coasts through) or just BEFORE it
        # (the alignment crawl backs out the near side). Those are opposite sides
        # from the same move direction, so assuming either one is wrong half the
        # time. The falling edge is what actually happened.
        self.travel_direction: Optional[str] = None
        self.flag_exit_direction: Optional[str] = None

    def set_shelf_settle(self, seconds: float) -> None:
        """Lockout applied AFTER a counted shelf, to swallow that shelf's bounce."""
        with self._lock:
            self._shelf_settle = max(0.0, seconds)

    def arm_shelf_lockout(self) -> None:
        """
        Start the bounce lockout NOW, without counting a shelf.

        Used when a move starts parked on a flag. That flag is about to be
        dragged out of the window and can rock back into it as the chain takes
        up; arming the lockout makes the hardware treat such a return as the
        bounce it is. Without this the first edge of every move was accepted
        unconditionally, because `reset_pulses` had just cleared the lockout.
        """
        with self._lock:
            self._last_counted = time.monotonic()

    def _on_shelf_exit(self) -> None:
        if self.travel_direction is not None:
            self.flag_exit_direction = self.travel_direction

    def _on_shelf(self) -> None:
        """
        RISING EDGE. Untriggered -> triggered. This is the event the whole machine
        stops on, so it is published IMMEDIATELY and unconditionally, unless it is
        a re-trigger of the shelf that was just counted.

        The bounce filter is a LOCKOUT AFTER a counted shelf, never a wait BEFORE
        one. That distinction is the entire bug that made the carousel drive past
        its target:

        This used to be release-based — an edge only counted if the window had
        been EMPTY for `settle` first. That puts a precondition in front of the
        stop signal, so the filter could DELAY or DROP the very edge that must cut
        power. It reliably did: on the last shelf the move drops to the slower
        `approach` duty, `settle` is recomputed for that slow duty (0.40s) while
        the carousel is still physically coasting near cruise (real gap 0.25s), so
        the target's arrival edge was swallowed every time and the loop ran on to
        the NEXT shelf. It also failed outright whenever the metal flag covered
        more than ~60% of the shelf pitch, because then the empty gap is shorter
        than the settle at any speed.

        A lockout cannot do that. The first edge after a reset always passes with
        zero delay, so trigger -> stop is exact; only the SAME shelf rocking back
        into the window inside the lockout is ignored.
        """
        now = time.monotonic()
        with self._lock:
            last = self._last_counted
            lockout = self._shelf_settle
            if last is not None and lockout > 0 and (now - last) < lockout:
                # Same shelf rocking in the window again, not the next shelf.
                self._suppressed_bounces += 1
                return
            self._last_counted = now
            self._shelf_pulses += 1
        self._shelf_tick.set()

    def _on_index(self) -> None:
        with self._lock:
            self._index_pulses += 1
        self._index_tick.set()

    # ---- motor backend (DC / one BTS7960 bridge) ----------------------------
    # `mirror_b` is read through `getattr` so a subclass that does not set it
    # (ServoHardware has its own) still constructs cleanly. The DC backend
    # drives one motor, so it only stores the flag for the `servo` snapshot.
    mirror_b: bool = DC_MIRROR_B

    def _channel(self) -> int:
        """The bridge index this carousel's motor is on: A unless twin Right."""
        mi = getattr(self, "motor_index", None)
        return mi if mi in (0, 1) else 0

    def _init_motor(self) -> None:
        from gpiozero import Motor, DigitalOutputDevice

        # BTS7960: passing NO `enable` to Motor makes gpiozero PWM the two
        # direction pins directly, which is exactly what RPWM/LPWM want — it
        # drives one pin with the duty cycle and holds the other at 0.
        # Index 0 is motor A, index 1 is motor B. Only the owned bridge is
        # claimed; the other one's pins stay free for a twin backend.
        pins = (
            (PIN_MOTOR_A_RPWM, PIN_MOTOR_A_LPWM, PIN_MOTOR_A_EN),
            (PIN_MOTOR_B_RPWM, PIN_MOTOR_B_LPWM, PIN_MOTOR_B_EN),
        )
        rpwm, lpwm, en = pins[self._channel()]
        self.motor = Motor(forward=rpwm, backward=lpwm, pwm=True)
        # R_EN and L_EN of the bridge tied to one GPIO: HIGH arms the bridge,
        # LOW makes the outputs float. Pulling this LOW is a true hardware stop
        # that works even if a PWM pin is stuck, so the estop path uses it.
        self.enable = DigitalOutputDevice(en, initial_value=True)
        self._motor_lock = threading.Lock()
        self._jog_abort = False

    def _drive(self, forward: bool, speed: float) -> None:
        """Run the bridge in the carousel's `forward` sense, honouring Reverse."""
        bridge_forward = forward != bool(getattr(self, "reverse", False))
        duty = max(0.0, min(1.0, float(speed)))
        self.enable.on()  # re-arm in case an estop left the bridge disabled
        if bridge_forward:
            self.motor.forward(duty)
        else:
            self.motor.backward(duty)

    def forward(self, speed: float) -> None:
        with self._motor_lock:
            self._drive(True, speed)

    def backward(self, speed: float) -> None:
        with self._motor_lock:
            self._drive(False, speed)

    def stop(self) -> None:
        # Zero the PWM first so the bridge brakes cleanly, then disarm it. Doing
        # it in this order avoids floating the outputs while a duty cycle is
        # still applied.
        with self._motor_lock:
            self.motor.stop()
            self.enable.off()

    def _close_motor(self) -> None:
        self.stop()  # leave the bridge disarmed on exit
        self.motor.close()
        self.enable.close()

    def jog(self, motor: str, direction: str, amount: int, speed: Optional[float] = None) -> None:
        """
        Timed jog: run the carousel's motor in `direction` for `amount`
        MILLISECONDS at a fixed duty. This is the DC equivalent of the servo's
        pulse-count jog. `motor` is accepted for protocol compatibility but a
        DC carousel has only one motor, so it is ignored. It blocks on the
        Carousel worker; `abort_jog()` (estop) cuts it short within one
        DC_JOG_SLICE_S.
        """
        ms = max(0, min(DC_JOG_MAX_MS, int(amount)))
        if ms == 0:
            return
        duty = DC_JOG_DUTY if speed is None else max(SLIDER_MIN_DUTY, min(1.0, float(speed)))
        # Same convention as Carousel._energise: "down" is the bridge's forward.
        forward = direction == "down"
        self._jog_abort = False
        with self._motor_lock:
            self._drive(forward, duty)
        deadline = time.monotonic() + ms / 1000.0
        try:
            while time.monotonic() < deadline:
                if self._jog_abort:
                    break
                time.sleep(min(DC_JOG_SLICE_S, max(0.0, deadline - time.monotonic())))
        finally:
            self.stop()

    def abort_jog(self) -> None:
        self._jog_abort = True

    def set_servo_params(self, mirror_b=None, **_: object) -> None:
        """
        Drive tuning from the app's `config`. Pulses/rate are servo-only and
        ignored; `mirror_b` is only remembered for the status snapshot.
        """
        if mirror_b is not None:
            self.mirror_b = bool(mirror_b)

    def servo_snapshot(self) -> Optional[dict]:
        """
        Drive status (`servo` event on the wire, kept for compatibility). In DC
        mode it tells the app which backend is live; there are no alarm lines
        on a BTS7960, so those fields are absent.
        """
        return {
            "type": "servo",
            "mode": "dc",
            "mirrorB": self.mirror_b,
            "jogMaxMs": DC_JOG_MAX_MS,
        }

    def reset_pulses(self) -> None:
        """Drop stale counts. Call before a move; never touches motor power."""
        with self._lock:
            self._shelf_pulses = 0
            self._index_pulses = 0
            # Clear the bounce lockout too. A move ends by stopping ON a flag, so
            # `_last_counted` is only milliseconds old when the next move starts.
            # Leaving it set would make the lockout suppress the NEXT move's first
            # genuine arrival — reintroducing the drive-past-the-target bug at the
            # start of every move instead of the end.
            self._last_counted = None
        self._shelf_tick.clear()
        self._index_tick.clear()

    def _take(self, kind: str, timeout: float) -> bool:
        """
        Consume one counted pulse, waiting up to `timeout` for one to arrive.
        The counter is the source of truth and the Event is only a wake-up
        hint, so a pulse landing between the check and the clear is still
        counted rather than lost.
        """
        tick = self._shelf_tick if kind == "shelf" else self._index_tick
        deadline = time.monotonic() + timeout
        while True:
            with self._lock:
                if kind == "shelf" and self._shelf_pulses > 0:
                    self._shelf_pulses -= 1
                    return True
                if kind == "index" and self._index_pulses > 0:
                    self._index_pulses -= 1
                    return True
            remaining = deadline - time.monotonic()
            if remaining <= 0:
                return False
            tick.clear()
            tick.wait(min(remaining, 0.05))

    def take_shelf_pulse(self, timeout: float) -> bool:
        return self._take("shelf", timeout)

    def take_index_pulse(self, timeout: float) -> bool:
        return self._take("index", timeout)

    def index_clear(self, timeout: float) -> bool:
        """
        Block until the index window is EMPTY, leaving motor power untouched so
        the carousel keeps driving off the flag while we watch.
        """
        deadline = time.monotonic() + timeout
        while self._index_level():
            if time.monotonic() >= deadline:
                return False
            time.sleep(0.005)
        return True

    # Every level read in this class goes through these two helpers, so the
    # inversion is applied in exactly one place per sensor and cannot drift
    # between the "is metal there now" checks and the "wait until it is gone"
    # loops. Reading `.is_active` directly anywhere below would bypass it.
    def _shelf_level(self) -> bool:
        """True when a shelf flag is in front of the sensor."""
        raw = bool(self.shelf.is_active)
        return (not raw) if SENSOR_INVERT else raw

    def _index_level(self) -> bool:
        """True when the home flag is in front of the sensor."""
        raw = bool(self.index.is_active)
        return (not raw) if SENSOR_INVERT else raw

    def index_active(self) -> bool:
        return self._index_level()

    def shelf_clear(self, timeout: float) -> bool:
        """
        Block until the shelf window is EMPTY, leaving motor power untouched so
        the carousel keeps driving off the flag while we watch.

        This is the counterpart to `index_clear` for the per-shelf sensor, and it
        is what makes parking ON the sensor safe: the level is only consulted to
        decide when COUNTING may begin, never whether the motor is energised.
        """
        deadline = time.monotonic() + timeout
        while self._shelf_level():
            if time.monotonic() >= deadline:
                return False
            time.sleep(0.005)
        return True

    def shelf_active(self) -> bool:
        return self._shelf_level()

    def in_shelf_lockout(self) -> bool:
        """
        True while metal in the window still belongs to the shelf just counted.

        The interrupt path applies this lockout in `_on_shelf`, but the counting
        loop ALSO detects shelves by polling `shelf_active()`, and that path had
        no lockout at all. So a flag rocking back into the window was rejected as
        a bounce on one path and accepted as a new shelf on the other -- which is
        how the lurch at the arrival changeover got counted and every multi-shelf
        move finished one shelf early. Exposing the same state lets the poll path
        honour the same decision instead of contradicting it.
        """
        with self._lock:
            last = self._last_counted
            lockout = self._shelf_settle
            if last is None or lockout <= 0:
                return False
            return (time.monotonic() - last) < lockout

    def cleanup(self) -> None:
        try:
            self._close_motor()
            self.shelf.close()
            self.index.close()
        except Exception:
            pass


class ServoHardware(RealHardware):
    """
    Two iSV57T integrated servos driven by pulse (PUL) and direction (DIR).

    Sensors, shelf counting and the lockout logic are inherited unchanged from
    RealHardware; only the motor half is replaced:

      * `forward`/`backward(speed)` set both DIR lines and start a continuous
        50 % duty pulse train on both PUL lines at `speed × max_pps` Hz. The
        drive runs in position mode (Pr0.01 = 0) and follows the pulse stream,
        so velocity control IS pulse-frequency control. Both channels carry the
        same frequency and direction, so the two motors stay synchronised.
      * `stop()` zeroes the duty: the PUL line goes low and the servo holds its
        last position with full torque. A stopped servo therefore brakes far
        harder than a coasting DC motor, which is why servo users see less
        overshoot and can usually run a faster approach.
      * `release()` / `engage()` drive the ENA inputs. Released, the motors are
        de-energised and the carousel can be turned by hand; the Carousel
        releases them after an idle timeout and every move/jog re-engages them
        first (with a short settle so no pulses are lost).
      * `jog(motor, direction, pulses)` bit-bangs an exact number of pulses to
        ONE motor (or both) at a slow rate. This is the alignment tool: if the
        two chains drift, nudge one side until the shelf hangs level.
    """

    motor_mode = "servo"

    def __init__(
        self,
        pulses_per_rev: int = SERVO_PULSES_PER_REV,
        max_pps: int = SERVO_MAX_PPS,
        mirror_b: bool = SERVO_MIRROR_B,
        ignore_alarm: bool = False,
        single_motor: bool = False,
        motor_index: Optional[int] = None,
        shelf_pin: int = PIN_SHELF_SENSOR,
        index_pin: int = PIN_INDEX_SENSOR,
        pulse_drive: str = PULSE_DRIVE_DEFAULT,
        ena_active_low: Optional[bool] = None,
        alm_active_low: Optional[bool] = None,
    ) -> None:
        # Drive profile first: it caps max_pps and sets the line polarities.
        self.pulse_drive = pulse_drive if pulse_drive in PULSE_DRIVES else PULSE_DRIVE_DEFAULT
        prof = pulse_drive_profile(self.pulse_drive)
        self.ena_active_low = bool(prof["ena_active_low"] if ena_active_low is None else ena_active_low)
        self.alm_active_low = bool(prof["alm_active_low"] if alm_active_low is None else alm_active_low)
        self.has_enable_input = bool(prof["has_enable"])
        self.drive_max_pps = int(prof["max_pps"])
        self.pulses_per_rev = max(1, int(pulses_per_rev))
        self.max_pps = max(SERVO_MIN_PPS, min(self._pps_ceiling(), int(max_pps)))
        self.mirror_b = bool(mirror_b)
        # One-servo hardware carousel: only channel A is pulsed and monitored.
        self.single_motor = bool(single_motor)
        # ALM has a pull-up, so an UNWIRED ALM pin reads exactly like a tripped
        # drive. Builds without ALM+/ALM- connected set this to run anyway.
        self.ignore_alarm = bool(ignore_alarm)
        super().__init__(motor_index=motor_index, shelf_pin=shelf_pin, index_pin=index_pin)

    # Hardware-style stop on a sensor edge, the Pi-header twin of the ESP32's
    # ARM command. Class defaults so subclasses that skip _init_motor (the
    # ESP32 backend) see a disarmed state and the callbacks stay pass-through.
    _gpio_arm: Optional[str] = None
    _gpio_arm_ready = False
    _gpio_arm_gap_s = 0.0
    _gpio_off_since = {"shelf": 0.0, "index": 0.0}
    _jog_abort = False

    def _pps_ceiling(self) -> int:
        """Highest pulse rate this controller can produce for the drive."""
        return min(self.drive_max_pps, SERVO_GPIO_MAX_PPS)

    def _init_sensors(self, shelf_pin: int, index_pin: int) -> None:
        super()._init_sensors(shelf_pin, index_pin)
        self._gpio_off_since = {"shelf": time.monotonic(), "index": time.monotonic()}
        # The base class only binds the index ARRIVAL edge; the arm needs the
        # departure too, to know how long the window has been empty.
        if SENSOR_INVERT:
            self.index.when_activated = self._on_index_exit
        else:
            self.index.when_deactivated = self._on_index_exit

    def _arm_left(self, sensor: str) -> None:
        self._gpio_off_since = {**self._gpio_off_since, sensor: time.monotonic()}
        if self._gpio_arm == sensor:
            self._gpio_arm_ready = True

    def _arm_arrived(self, sensor: str) -> None:
        """Mirror of the firmware's armCheck(): cut the train on the armed arrival."""
        if self._gpio_arm != sensor or not self._gpio_arm_ready:
            return
        if time.monotonic() - self._gpio_off_since.get(sensor, 0.0) < self._gpio_arm_gap_s:
            # A flag rocking back into the window: wait for a real departure.
            self._gpio_arm_ready = False
            return
        self._gpio_arm = None
        # Straight from the GPIO callback thread: PUL goes low now, before the
        # Carousel worker even sees the edge. Like the ESP32 this is not a latch;
        # the next forward()/backward() starts the train again.
        self.stop()

    def _on_shelf_exit(self) -> None:
        super()._on_shelf_exit()
        self._arm_left("shelf")

    def _on_index_exit(self) -> None:
        self._arm_left("index")

    def _on_shelf(self) -> None:
        self._arm_arrived("shelf")
        super()._on_shelf()

    def _on_index(self) -> None:
        self._arm_arrived("index")
        super()._on_index()

    def arm_stop(self, sensor: str = "shelf", min_gap_s: float = 0.0) -> None:
        """
        Stop the pulse train on the next ARRIVAL edge of `sensor` ("shelf" or
        "index") from the sensor callback itself, the same contract as the
        ESP32 backend: the edge still reaches the counters, only the stop
        happens earlier. `min_gap_s` = how long the window must have been empty.
        """
        sensor = "index" if sensor == "index" else "shelf"
        level = self._index_level() if sensor == "index" else self._shelf_level()
        self._gpio_arm_gap_s = max(0.0, float(min_gap_s))
        # Ready only once the window has been seen empty since arming.
        self._gpio_arm_ready = not level
        self._gpio_arm = sensor

    def disarm(self) -> None:
        self._gpio_arm = None

    def abort_jog(self) -> None:
        """Cut a running jog between two pulses (estop / Stop button)."""
        self._jog_abort = True

    def _channels(self) -> tuple:
        """Servo channels this backend owns: both, or just its twin-side one."""
        mi = getattr(self, "motor_index", None)
        return (mi,) if mi in (0, 1) else (0, 1)

    def _init_motor(self) -> None:
        from gpiozero import PWMOutputDevice, DigitalOutputDevice, DigitalInputDevice

        # Twin mode claims only this side's channel; the other stays None so the
        # second backend on the same Pi can own those pins.
        owned = self._channels()

        def pair(make_a, make_b):
            return (make_a() if 0 in owned else None, make_b() if 1 in owned else None)

        self.pul = pair(
            lambda: PWMOutputDevice(PIN_SERVO_PUL_A, frequency=SERVO_IDLE_HZ, initial_value=0),
            lambda: PWMOutputDevice(PIN_SERVO_PUL_B, frequency=SERVO_IDLE_HZ, initial_value=0),
        )
        self.dir = pair(
            lambda: DigitalOutputDevice(PIN_SERVO_DIR_A, initial_value=False),
            lambda: DigitalOutputDevice(PIN_SERVO_DIR_B, initial_value=False),
        )
        # ALM is an opto-isolated open-collector output that CONDUCTS in normal
        # operation and goes high-impedance on a fault. With the Pi's pull-up,
        # gpiozero's `is_active` (pin LOW) therefore means "healthy".
        self.alm = pair(
            lambda: DigitalInputDevice(PIN_SERVO_ALM_A, pull_up=True, bounce_time=0.05),
            lambda: DigitalInputDevice(PIN_SERVO_ALM_B, pull_up=True, bounce_time=0.05),
        )
        # Start ENGAGED (holding) so power-up matches the drive's own default.
        # `active_high` folds the polarity in: `.on()` always means "release".
        # Integrated servos have no enable input, so GPIO 17/25 drive the
        # optional supply relay (SERVO_ENA_ACTIVE_RELEASES). AC servos and
        # closed-loop steppers have one (S-ON / MF): "engaged" is GPIO HIGH
        # unless the profile / app says the line is active-low, so "release"
        # (.on()) is the opposite level.
        release_is_high = (not self.has_enable_input and SERVO_ENA_ACTIVE_RELEASES) or (self.has_enable_input and self.ena_active_low)
        self.ena = pair(
            lambda: DigitalOutputDevice(PIN_SERVO_ENA_A, active_high=release_is_high, initial_value=False),
            lambda: DigitalOutputDevice(PIN_SERVO_ENA_B, active_high=release_is_high, initial_value=False),
        )
        self._held = True
        self._motor_lock = threading.Lock()
        self._pulsing = False
        self._forward: Optional[bool] = None
        # Pulse ODOMETER. The pulse train is a PWM carrier at a set frequency,
        # so nothing counts the individual pulses; instead every segment of
        # constant frequency is integrated (hz × seconds, signed by direction)
        # the moment it ends. The drive steps once per pulse, so this IS the
        # commanded position, good to well under a percent — and the index flag
        # re-syncs the remainder on every pass (see Carousel._do_goto_pulses).
        self._odo_lock = threading.Lock()
        self._odo_pulses = 0.0
        self._odo_hz = 0
        self._odo_sign = 0
        self._odo_t0 = time.monotonic()

    def _odo_close_segment(self) -> None:
        """Bank the segment that is ending. Caller holds `_odo_lock`."""
        now = time.monotonic()
        if self._odo_hz > 0 and self._odo_sign != 0:
            self._odo_pulses += self._odo_sign * self._odo_hz * (now - self._odo_t0)
        self._odo_t0 = now

    def _odo_segment(self, hz: int, sign: int) -> None:
        """Start a new constant-frequency segment (hz=0 or sign=0 = stopped)."""
        with self._odo_lock:
            self._odo_close_segment()
            self._odo_hz = hz
            self._odo_sign = sign

    def pulse_position(self) -> float:
        """Signed pulses sent since start-up: forward() counts up, backward() down."""
        with self._odo_lock:
            self._odo_close_segment()
            return self._odo_pulses

    def pulse_rate(self, speed: float) -> float:
        """Pulses per second the carrier runs at for a 0..1 speed."""
        return float(self._hz_for(speed))

    @property
    def held(self) -> bool:
        """True while the servos are energised and holding position."""
        return self._held

    def engage(self) -> None:
        """Re-energise both servos. Blocks for the settle time if they were released."""
        with self._motor_lock:
            if self._held:
                return
            for e in _present(self.ena):
                e.off()
            time.sleep(SERVO_ENA_INPUT_SETTLE_S if self.has_enable_input else SERVO_ENABLE_SETTLE_S)
            self._held = True

    def release(self) -> None:
        """De-energise both servos so the carousel can be moved by hand."""
        with self._motor_lock:
            self._gpio_arm = None
            self._odo_segment(0, 0)
            for p in _present(self.pul):
                p.value = 0
            self._pulsing = False
            for e in _present(self.ena):
                e.on()
            self._held = False

    # The motion code's "forward"/"backward" map onto DIR levels here. Motor B
    # is mirrored when the two servos face each other across the carousel.
    def _dir_levels(self, forward: bool) -> tuple[bool, bool]:
        if self.motor_index is not None:
            level = forward != bool(getattr(self, "reverse", False))
            return level, level
        a = forward
        b = (not forward) if self.mirror_b else forward
        return a, b

    def _hz_for(self, speed: float) -> int:
        speed = max(0.0, min(1.0, float(speed)))
        return max(SERVO_MIN_PPS, int(round(speed * self.max_pps)))

    def _active_pul(self) -> tuple:
        """PUL outputs that drive the carousel: A only on a one-servo build."""
        if self.motor_index is not None:
            return _present(self.pul)
        return self.pul[:1] if self.single_motor else self.pul

    def _set_dir(self, forward: bool) -> None:
        a, b = self._dir_levels(forward)
        if self.dir[0] is not None:
            self.dir[0].value = a
        if self.dir[1] is not None:
            self.dir[1].value = b

    def _run_pulses(self, forward: bool, speed: float) -> None:
        self.engage()
        with self._motor_lock:
            hz = self._hz_for(speed)
            if not self._pulsing or self._forward != forward:
                # Never flip DIR under a running pulse train: stop, set the
                # direction, give it the setup time the drive asks for, resume.
                self._odo_segment(0, 0)
                for p in _present(self.pul):
                    p.value = 0
                self._set_dir(forward)
                time.sleep(SERVO_DIR_SETUP_S)
            for p in self._active_pul():
                p.frequency = hz
            for p in self._active_pul():
                p.value = 0.5
            self._odo_segment(hz, 1 if forward else -1)
            self._pulsing = True
            self._forward = forward

    def forward(self, speed: float) -> None:
        self._run_pulses(True, speed)

    def backward(self, speed: float) -> None:
        self._run_pulses(False, speed)

    def stop(self) -> None:
        with self._motor_lock:
            self._odo_segment(0, 0)
            for p in _present(self.pul):
                p.value = 0
            self._pulsing = False

    def _close_motor(self) -> None:
        self.stop()
        # Leave the drives in their power-up (enabled) state, not released.
        for e in _present(self.ena):
            e.off()
        for dev in _present((*self.pul, *self.dir, *self.alm, *self.ena)):
            dev.close()

    def jog(self, motor: str, direction: str, amount: int, speed: Optional[float] = None) -> None:
        """
        Send exactly `amount` pulses to motor "a", "b" or "both" in `direction`
        ("up"/"down", the same words the move logic uses). `speed` is accepted
        for signature parity with the DC backend and ignored: the jog rate is
        fixed so the pulse count stays exact. Blocking; runs on the Carousel
        worker so an estop (`stop()` + abort) can cut it short only between
        pulses — a few hundred microseconds.
        """
        pulses = max(0, min(SERVO_JOG_MAX_PULSES, int(amount)))
        if pulses == 0:
            return
        if self.motor_index is not None:
            # Twin side: its one servo IS this carousel's drive.
            motor = "both"
            targets = (self.motor_index,)
        elif self.single_motor:
            # The one servo IS the carousel drive: any jog moves the carousel,
            # and channel B has nothing connected.
            if motor == "b":
                return
            motor = "both"
            targets = (0,)
        else:
            targets = (0, 1) if motor == "both" else ((0,) if motor == "a" else (1,))
        self.engage()
        # Same convention as Carousel._energise: "down" is the bridge's forward.
        forward = direction == "down"
        half = 0.5 / SERVO_JOG_PPS
        with self._motor_lock:
            self._odo_segment(0, 0)
            for p in _present(self.pul):
                p.value = 0
            self._pulsing = False
            self._set_dir(forward)
            time.sleep(SERVO_DIR_SETUP_S)
            self._jog_abort = False
            sent = 0
            for _ in range(pulses):
                if self._jog_abort:
                    break
                for i in targets:
                    self.pul[i].value = 1
                time.sleep(half)
                for i in targets:
                    self.pul[i].value = 0
                time.sleep(half)
                sent += 1
            # Only a jog of BOTH chains moves the carousel; nudging one side
            # levels a shelf without changing where the carousel is.
            if motor == "both" and sent:
                with self._odo_lock:
                    self._odo_close_segment()
                    self._odo_pulses += (1 if forward else -1) * sent

    def set_servo_params(
        self,
        pulses_per_rev=None,
        max_pps=None,
        mirror_b=None,
        ignore_alarm=None,
        single_motor=None,
        **_: object,
    ) -> None:
        if pulses_per_rev is not None:
            self.pulses_per_rev = max(1, int(pulses_per_rev))
        if max_pps is not None:
            self.max_pps = max(SERVO_MIN_PPS, min(self._pps_ceiling(), int(max_pps)))
        if mirror_b is not None:
            self.mirror_b = bool(mirror_b)
        if ignore_alarm is not None:
            self.ignore_alarm = bool(ignore_alarm)
        if single_motor is not None:
            with self._motor_lock:
                self.single_motor = bool(single_motor)
                if self.single_motor and self.motor_index is None and self.pul[1] is not None:
                    self.pul[1].value = 0

    def _alm_tripped(self, dev) -> bool:
        """Read one ALM input in the drive's polarity (pull-up: is_active = pin LOW)."""
        # Conducts-while-healthy drives (iSV57T, A6-RS): LOW = fine, open = fault.
        # Conducts-on-fault drives (CL86Y): LOW = fault, open = fine.
        return bool(dev.is_active) if self.alm_active_low else not dev.is_active

    def alarms(self) -> tuple[bool, bool]:
        """(motor A alarm, motor B alarm) — True when the drive has tripped."""
        if self.ignore_alarm:
            return (False, False)
        # An unused channel has no drive on its ALM, so its pull-up would read
        # as a permanent fault; unowned / one-servo channels never report.
        a = self.alm[0] is not None and self._alm_tripped(self.alm[0])
        b_used = self.alm[1] is not None and not (self.single_motor and self.motor_index is None)
        b = b_used and self._alm_tripped(self.alm[1])
        return (a, b)

    def servo_snapshot(self) -> Optional[dict]:
        a, b = self.alarms()
        return {
            "type": "servo",
            "mode": "servo",
            "alarmA": a,
            "alarmB": b,
            "ignoreAlarm": self.ignore_alarm,
            "pulsesPerRev": self.pulses_per_rev,
            "maxPps": self.max_pps,
            "mirrorB": self.mirror_b,
            "singleMotor": self.single_motor,
            "held": self._held,
            "pulseDrive": self.pulse_drive,
            "enableActiveLow": self.ena_active_low,
            "alarmActiveLow": self.alm_active_low,
        }


class _TcpLink:
    """
    Just enough of pyserial's Serial surface (read / in_waiting / write /
    close) over a TCP socket, so the ESP32 backend runs unchanged whether the
    board hangs off a USB cable or sits on the other side of the hall on Wi-Fi.
    """

    def __init__(self, sock) -> None:
        self._sock = sock
        sock.settimeout(0.05)
        try:
            sock.setsockopt(socket.IPPROTO_TCP, socket.TCP_NODELAY, 1)
        except OSError:
            pass

    @property
    def in_waiting(self) -> int:
        r, _, _ = select.select([self._sock], [], [], 0)
        return 4096 if r else 0

    def read(self, n: int = 1) -> bytes:
        try:
            data = self._sock.recv(max(1, n))
        except socket.timeout:
            return b""
        if not data:
            raise ConnectionError("peer closed the link")
        return data

    def write(self, data: bytes) -> int:
        self._sock.sendall(data)
        return len(data)

    def close(self) -> None:
        try:
            self._sock.shutdown(socket.SHUT_RDWR)
        except OSError:
            pass
        self._sock.close()


# Every live ESP32 backend, so the networking layer can hand new Wi-Fi
# credentials to standalone boards without holding a reference to the motor.
_ESP32_LINKS: "weakref.WeakSet" = weakref.WeakSet()


def esp32_wifi_links() -> list:
    return [h for h in list(_ESP32_LINKS) if getattr(h, "wifi", False)]


class Esp32ServoHardware(ServoHardware):
    """
    Two A6-RS servo drives behind an ESP32 running pi-agent/esp32-servo.

    Same contract as ServoHardware, but nothing here touches a GPIO: every
    motor verb becomes a line on the serial link (RUN/STOP/ENA/JOG/HOLD/FREE)
    and both sensors are read BY THE ESP32, which streams their edges back
    with a microsecond timestamp. The edges are fed into the very same
    counters, lockout and direction memory that the GPIO backends use
    (`_on_shelf`, `_on_index`, `_on_shelf_exit`), so the Carousel's motion
    logic sees an identical sensor model — just with sub-millisecond latency
    and a pulse train that no Linux scheduling can disturb.

    Two things only this backend offers:
      * `arm_stop("shelf")` makes the ESP32 itself cut the pulse train on the
        next arrival edge, before the edge has even reached the Pi. The
        Carousel arms it for the target shelf of every move.
      * the link is supervised both ways: the firmware stops the motors after
        1.5 s without a line from the Pi, and the agent flags `linkOk=False`
        (which the Carousel turns into a fault) when status lines stop.
    """

    driver = "esp32"

    def __init__(
        self,
        link: str = ESP32_LINK_DEFAULT,
        port: str = "",
        baud: int = ESP32_BAUD_DEFAULT,
        **kw,
    ) -> None:
        self.link = link if link in ESP32_LINKS else ESP32_LINK_DEFAULT
        self.port_setting = (port or "").strip()
        self.baud = int(baud) if baud else ESP32_BAUD_DEFAULT
        self._ser = None
        self._net: dict = {}                    # last NET reply from a Wi-Fi board
        self._net_requested = 0.0
        _ESP32_LINKS.add(self)
        self._ser_lock = threading.Lock()
        self._state_lock = threading.Lock()
        self._levels = [False, False]          # gpiozero-sense active levels, shelf / home
        self._alarms = (False, False)
        self._esp_pos = 0.0
        self._connected = False
        self._firmware: Optional[str] = None
        self._port_in_use: Optional[str] = None
        self._link_error: Optional[str] = None
        self._last_status = 0.0
        self._last_ping = 0.0
        self._last_pong = time.monotonic()
        self._pong_warned = False
        self._hello_seen = threading.Event()
        self._jog_done = threading.Event()
        self._jog_sent = 0
        self._stop_reader = threading.Event()
        self._reader: Optional[threading.Thread] = None
        self._armed: Optional[str] = None
        self._trip_pos: Optional[float] = None
        super().__init__(**kw)

    # ---- construction hooks (no GPIO) --------------------------------------
    def _init_motor(self) -> None:
        self._held = True
        # What the ESP32 itself says about the enable line (ST ena= / OK ENA).
        # None = not reported yet, so the first move always enables and waits.
        self._esp_ena: Optional[bool] = None
        self._ena_ack = threading.Event()
        self._motor_lock = threading.Lock()
        self._pulsing = False
        self._forward: Optional[bool] = None
        self._jog_abort = False
        self._odo_lock = threading.Lock()
        self._odo_pulses = 0.0
        self._odo_hz = 0
        self._odo_sign = 0
        self._odo_t0 = time.monotonic()

    def _init_sensors(self, shelf_pin: int, index_pin: int) -> None:
        # Sensors live on the ESP32; start the link once the counters exist.
        import serial  # noqa: F401  (pyserial) -- fail here, at construction, if missing
        self._reader = threading.Thread(target=self._reader_loop, name="esp32-link", daemon=True)
        self._reader.start()
        # Give the first connection a moment so `hello` can report the real state.
        self._hello_seen.wait(ESP32_HELLO_TIMEOUT_S)

    # ---- serial link --------------------------------------------------------
    def _candidate_ports(self) -> list:
        if self.port_setting:
            return [self.port_setting]
        if self.link == "uart":
            return [ESP32_UART_PORT]
        found: list = []
        try:
            import glob
            for p in sorted(glob.glob("/dev/serial/by-id/*")):
                found.append(p)
        except Exception:
            pass
        for p in ESP32_USB_CANDIDATES:
            if p not in found and os.path.exists(p):
                found.append(p)
        return found or list(ESP32_USB_CANDIDATES[:1])

    @property
    def wifi(self) -> bool:
        return self.link == "wifi"

    def _wifi_target(self) -> tuple:
        """host[:port] from the "port" setting; the firmware's default port otherwise."""
        host, _, port = self.port_setting.rpartition(":")
        if not host:
            host, port = self.port_setting, ""
        try:
            return host.strip(), int(port) if port else ESP32_WIFI_PORT
        except ValueError:
            return host.strip(), ESP32_WIFI_PORT

    def _open_port(self) -> bool:
        if self.wifi:
            return self._open_wifi()
        import serial
        for path in self._candidate_ports():
            try:
                ser = serial.Serial(path, self.baud, timeout=0.05, write_timeout=0.5)
            except Exception as exc:
                self._link_error = f"{path}: {exc}"
                continue
            with self._ser_lock:
                self._ser = ser
                self._port_in_use = path
            self._hello_seen.clear()
            # A USB-serial open pulses DTR, which resets the DevKit; it answers
            # HELLO once it has rebooted, so ask more than once.
            deadline = time.monotonic() + ESP32_HELLO_TIMEOUT_S
            while time.monotonic() < deadline and not self._hello_seen.is_set():
                self._send("HELLO")
                self._pump(0.4)
            if self._hello_seen.is_set():
                self._link_error = None
                return True
            self._link_error = f"{path}: no HELLO from the ESP32 (wrong port, baud {self.baud}, or firmware not flashed)"
            self._drop_link(self._link_error, quiet=True)
        return False

    def _open_wifi(self) -> bool:
        host, port = self._wifi_target()
        if not host:
            self._link_error = "no ESP32 host set — enter its hostname (pax-esp32-xxxx.local) or IP in the app"
            return False
        label = f"{host}:{port}"
        try:
            sock = socket.create_connection((host, port), timeout=ESP32_WIFI_CONNECT_TIMEOUT_S)
        except Exception as exc:
            self._link_error = f"{label}: {exc}"
            return False
        link = _TcpLink(sock)
        with self._ser_lock:
            self._ser = link
            self._port_in_use = label
        self._hello_seen.clear()
        deadline = time.monotonic() + ESP32_HELLO_TIMEOUT_S
        while time.monotonic() < deadline and not self._hello_seen.is_set():
            self._send("HELLO")
            self._pump(0.4)
        if self._hello_seen.is_set():
            self._link_error = None
            return True
        self._link_error = f"{label}: connected but no HELLO (is that a PAX ESP32 on port {port}?)"
        self._drop_link(self._link_error, quiet=True)
        return False

    def push_wifi(self, ssid: Optional[str], psk: Optional[str],
                  ap_ssid: Optional[str], ap_psk: Optional[str]) -> bool:
        """Store router and/or master-hotspot credentials on a Wi-Fi board.
        The board re-evaluates what to join right away, so a router change
        drops this socket — the reader loop reconnects on the new network."""
        if not self.wifi or not self._connected:
            return False
        if ap_ssid:
            self._send(f"WIFIAP {ap_ssid} {ap_psk or ''}".rstrip())
        if ssid:
            self._send(f"WIFI {ssid} {psk or ''}".rstrip())
        return True

    def net_status(self) -> dict:
        """Last NET reply (state/ssid/ip/rssi/host) plus link facts, for net.status."""
        with self._state_lock:
            n = dict(self._net)
            n["linkOk"] = self._connected
            n["target"] = self._port_in_use or self.port_setting
        return n

    def _after_hello(self) -> None:
        self._send_cfg()
        self._send(f"ENA {1 if self._held else 0}")
        self._send("STOP")
        if self.wifi:
            self._send("NET")
            self._net_requested = time.monotonic()
        elif self._firmware_at_least(1, 6):
            # A Pi master on USB/UART: the ESP32's Wi-Fi only steals loop time
            # from the link. Persisted on the board; WIFIOFF 0 turns it back on.
            self._send("WIFIOFF 1")

    def _firmware_at_least(self, major: int, minor: int) -> bool:
        try:
            parts = [int(p) for p in str(self._firmware).split(".")[:2]]
        except ValueError:
            return False
        while len(parts) < 2:
            parts.append(0)
        return tuple(parts) >= (major, minor)
        with self._state_lock:
            self._connected = True
            self._last_status = time.monotonic()
        self._pulsing = False

    def _send_cfg(self) -> None:
        self._send(
            "CFG "
            f"mirror={1 if self.mirror_b else 0} "
            f"single={1 if (self.single_motor and self.motor_index is None) else 0} "
            f"rev={1 if getattr(self, 'reverse', False) else 0} "
            f"npn={1 if SENSOR_TYPE.upper() == 'NPN' else 0} "
            f"maxpps={self.max_pps} "
            f"bounce_us={int(SENSOR_BOUNCE * 1_000_000)} "
            f"dirsetup_us={max(5, int(SERVO_DIR_SETUP_S * 1_000_000))} "
            f"jogpps={SERVO_JOG_PPS} "
            # One firmware for every PUL/DIR drive: the profile picks the
            # pulse ceiling and minimum pulse width on the board, and the two
            # polarity flags tell it which way the enable and alarm lines go.
            f"profile={self.pulse_drive} "
            f"ena_low={1 if self.ena_active_low else 0} "
            f"alm_low={1 if self.alm_active_low else 0} "
            # Wi-Fi hiccups must not stop the chains every time a frame is late.
            f"wd_ms={int(self._status_timeout_s() * 1000)}"
        )

    def _status_timeout_s(self) -> float:
        return ESP32_WIFI_STATUS_TIMEOUT_S if self.wifi else ESP32_STATUS_TIMEOUT_S

    def _send(self, line: str) -> None:
        with self._ser_lock:
            ser = self._ser
            if ser is None:
                return
            try:
                ser.write((line + "\n").encode("ascii", "replace"))
            except Exception as exc:
                self._drop_link(f"write failed: {exc}", quiet=False, locked=True)

    def _drop_link(self, reason: str, quiet: bool = False, locked: bool = False) -> None:
        if not locked:
            self._ser_lock.acquire()
        try:
            ser, self._ser = self._ser, None
        finally:
            if not locked:
                self._ser_lock.release()
        if ser is not None:
            try:
                ser.close()
            except Exception:
                pass
        with self._state_lock:
            was = self._connected
            self._connected = False
            self._link_error = reason
        self._rxbuf = b""
        self._pulsing = False
        self._odo_segment(0, 0)
        self._jog_done.set()
        if was and not quiet:
            print(f"[agent] ESP32 link lost: {reason}", flush=True)

    def _pump(self, seconds: float) -> None:
        """Read and dispatch link traffic for up to `seconds`."""
        end = time.monotonic() + seconds
        buf = getattr(self, "_rxbuf", b"")
        while time.monotonic() < end:
            with self._ser_lock:
                ser = self._ser
            if ser is None:
                return
            try:
                chunk = ser.read(max(1, ser.in_waiting))
            except Exception as exc:
                # pyserial raises "device reports readiness to read but returned
                # no data" when a single read comes back empty — a stray wake-up
                # on the Pi UART, not a lost board. Ride out short bursts; a real
                # disconnect keeps failing or trips the status timeout instead.
                if "returned no data" in str(exc):
                    self._read_glitches = getattr(self, "_read_glitches", 0) + 1
                    if self._read_glitches < ESP32_READ_GLITCH_LIMIT:
                        time.sleep(0.01)
                        continue
                self._read_glitches = 0
                self._drop_link(f"read failed: {exc}")
                return
            self._read_glitches = 0
            if chunk:
                buf += chunk
                while b"\n" in buf:
                    raw, buf = buf.split(b"\n", 1)
                    self._handle_line(raw.decode("ascii", "replace").strip())
            self._rxbuf = buf

    def _reader_loop(self) -> None:
        while not self._stop_reader.is_set():
            if self._ser is None:
                if not self._open_port():
                    self._stop_reader.wait(ESP32_RECONNECT_S)
                    continue
                self._after_hello()
                via = "wifi" if self.wifi else f"{self.link}, {self.baud} baud"
                print(f"[agent] ESP32 servo controller on {self._port_in_use} ({via}, fw {self._firmware})", flush=True)
            self._pump(0.1)
            now = time.monotonic()
            if now - self._last_ping >= ESP32_PING_S:
                self._last_ping = now
                self._send("PING")
            # The ESP32 still talking while ignoring our PINGs means the
            # Pi -> ESP32 direction is garbled (mini-UART baud drift, noise on
            # the TX wire): its watchdog will keep stopping moves after 1.5 s.
            if self._connected and now - self._last_pong > 1.2:
                if not self._pong_warned:
                    self._pong_warned = True
                    print(
                        f"[agent] ESP32 is not answering PING ({now - self._last_pong:.1f} s) - "
                        "it is not hearing the Pi; check the TX wire and that /dev/serial0 is the PL011 UART",
                        flush=True,
                    )
            elif self._pong_warned:
                self._pong_warned = False
                print("[agent] ESP32 answering PING again", flush=True)
            if self._connected and now - self._last_status > self._status_timeout_s():
                self._drop_link("no status from the ESP32")
            if self.wifi and self._connected and now - self._net_requested > 30:
                self._net_requested = now
                self._send("NET")

    # ---- inbound lines ------------------------------------------------------
    def _apply_level(self, sensor: int, level: bool) -> None:
        """Route a level change into the shared counters, honouring SENSOR_INVERT."""
        prev = self._levels[sensor]
        if level == prev:
            return
        self._levels[sensor] = level
        arrival_is_active = not SENSOR_INVERT
        if sensor == 0:
            if level == arrival_is_active:
                self._on_shelf()
            else:
                self._on_shelf_exit()
        elif level == arrival_is_active:
            self._on_index()

    def _handle_line(self, line: str) -> None:
        if not line:
            return
        # Any complete line proves the board is alive. Only ST used to count,
        # so a few garbled status lines in a row dropped a link that was fine.
        with self._state_lock:
            self._last_status = time.monotonic()
        head, _, rest = line.partition(" ")
        if head == "E":
            parts = rest.split()
            if len(parts) >= 2:
                sensor = 0 if parts[0] == "S" else 1
                self._apply_level(sensor, parts[1] == "1")
                if len(parts) >= 4:
                    try:
                        self._esp_pos = float(parts[3])
                    except ValueError:
                        pass
        elif head == "ST":
            fields = {}
            for tok in rest.split():
                k, _, v = tok.partition("=")
                fields[k] = v
            with self._state_lock:
                self._last_status = time.monotonic()
                self._alarms = (fields.get("aa") == "1", fields.get("ab") == "1")
                try:
                    self._esp_pos = float(fields.get("pos", self._esp_pos))
                except ValueError:
                    pass
                if fields.get("arm") == "0":
                    self._armed = None
                if fields.get("ena") in ("0", "1"):
                    self._esp_ena = fields["ena"] == "1"
            # The Pi's position is speed x time, so a train the ESP32 stopped on
            # its own would keep "moving" in the web app. ST says run=0 while we
            # still think it runs: freeze the odometer and flag the move.
            last_run = getattr(self, "_last_run_at", 0.0)
            if (fields.get("run") == "0" and self._pulsing
                    and time.monotonic() - last_run > 0.5):
                self._motion_lost(f"why={fields.get('why', '?')} ff={fields.get('ff', '?')}")
            # Levels are also in the status: a lost edge line re-syncs here.
            if "s" in fields:
                self._apply_level(0, fields["s"] == "1")
            if "h" in fields:
                self._apply_level(1, fields["h"] == "1")
        elif head == "HELLO":
            for tok in rest.split():
                if tok.startswith("fw="):
                    self._firmware = tok[3:]
                elif tok.startswith("host="):
                    with self._state_lock:
                        self._net["host"] = tok[5:]
            self._hello_seen.set()
        elif head == "NET":
            fields = {}
            for tok in rest.split():
                k, _, v = tok.partition("=")
                fields[k] = v
            with self._state_lock:
                self._net.update(fields)
                self._net["at"] = time.time()
        elif head == "TRIP":
            print(f"[agent] ESP32 TRIP (stopped on sensor edge): {rest}", flush=True)
            parts = rest.split()
            self._pulsing = False
            self._odo_segment(0, 0)
            self._armed = None
            try:
                self._trip_pos = float(parts[2]) if len(parts) >= 3 else None
            except ValueError:
                self._trip_pos = None
        elif head == "JOGDONE":
            try:
                self._jog_sent = int(rest.strip() or 0)
            except ValueError:
                self._jog_sent = 0
            self._jog_done.set()
        elif head == "BOOT":
            # The board restarted under us (brown-out, reset button): its config
            # and enable state are gone, so push them again.
            print("[agent] ESP32 restarted (BOOT) - config resent", flush=True)
            if self._pulsing:
                self._motion_lost("ESP32 restarted (BOOT)")
            if self._jog_active_flag():
                self._jog_sent = 0
                self._jog_done.set()
            if self._connected:
                self._pulsing = False
                self._odo_segment(0, 0)
                self._send_cfg()
                self._send(f"ENA {1 if self._held else 0}")
        elif head == "EV":
            print(f"[agent] ESP32: {rest}", flush=True)
            if "WATCHDOG" in rest:
                if self._pulsing:
                    self._motion_lost("ESP32 watchdog")
                self._pulsing = False
                self._odo_segment(0, 0)
        elif head == "OK" and rest.startswith("PING"):
            self._last_pong = time.monotonic()
        elif head == "OK" and rest.startswith("ENA"):
            self._esp_ena = rest.split()[-1] == "1"
            self._ena_ack.set()
        elif head == "ERR":
            print(f"[agent] ESP32 rejected a command: {rest}", flush=True)

    # ---- sensor levels (read from the link, not a pin) ----------------------
    def _shelf_level(self) -> bool:
        raw = self._levels[0]
        return (not raw) if SENSOR_INVERT else raw

    def _index_level(self) -> bool:
        raw = self._levels[1]
        return (not raw) if SENSOR_INVERT else raw

    # ---- motor verbs --------------------------------------------------------
    @property
    def link_ok(self) -> bool:
        return self._connected

    def engage(self) -> None:
        """Make sure the drives are enabled before any pulse goes out.

        The Pi's own `_held` flag is not enough: after a restart, a BOOT, or an
        idle release the ESP32 can have the drives off while the Pi still thinks
        they hold. The firmware's RUN would then enable and pulse in the same
        instant, and a closed-loop drive that is still waking up ignores those
        pulses while the Pi counts them as travel. So unless the ESP32 itself
        has confirmed ena=1, send ENA 1, wait for its OK, then give the drives
        their settle time before the move starts."""
        with self._motor_lock:
            if self._held and self._esp_ena is True:
                return
            self._ena_ack.clear()
            self._send("ENA 1")
            if self._ena_ack.wait(1.0):
                print(f"[agent] drives were idle; ESP32 enabled them, waiting "
                      f"{SERVO_ENABLE_SETTLE_S:.1f} s before moving", flush=True)
            else:
                print("[agent] ESP32 did not confirm ENA 1 within 1 s; "
                      "waiting the settle time anyway", flush=True)
            time.sleep(SERVO_ENABLE_SETTLE_S)
            self._held = True

    def release(self) -> None:
        with self._motor_lock:
            self._odo_segment(0, 0)
            self._pulsing = False
            self._send("ENA 0")
            self._held = False
            self._esp_ena = False

    def _jog_active_flag(self) -> bool:
        ev = getattr(self, "_jog_done", None)
        return ev is not None and not ev.is_set()

    def _motion_lost(self, reason: str) -> None:
        """The ESP32 stopped pulsing without being told to. Freeze the position
        where it stopped and keep the rest of this move from restarting it."""
        self._odo_segment(0, 0)
        self._pulsing = False
        self._motion_fault = reason
        print(f"[agent] ESP32 stopped the motor by itself during a move ({reason}); "
              "position frozen, move will not resume", flush=True)

    def _run_pulses(self, forward: bool, speed: float) -> None:
        if getattr(self, "_motion_fault", None):
            # Leave it stopped: the move times out and reports an error instead
            # of the web app showing a shelf the carousel never reached.
            return
        self.engage()
        with self._motor_lock:
            hz = self._hz_for(speed)
            # The move loop ramps every 1 ms, so an exact hz meant ~1000 RUN
            # lines a second, each one reprogramming the LEDC timer and
            # flooding the link. 64 speed steps across the range keep the ramp
            # smooth with a few dozen RUNs per ramp.
            step = max(1, int(self.max_pps) // 64)
            hz = max(SERVO_MIN_PPS, int(round(hz / step)) * step)
            # Homing re-asserts the speed every 20 ms; resending an unchanged
            # RUN only floods the link and re-programs the pulse timer.
            if self._pulsing and self._forward == forward and getattr(self, "_run_hz", None) == hz:
                return
            if not self._pulsing or self._forward != forward:
                self._odo_segment(0, 0)
            self._send(f"RUN {1 if forward else -1} {hz}")
            self._last_run_at = time.monotonic()
            self._run_hz = hz
            self._odo_segment(hz, 1 if forward else -1)
            self._pulsing = True
            self._forward = forward

    def stop(self) -> None:
        with self._motor_lock:
            if self._pulsing:
                # Diagnostic: name the code path that ends a running move, so a
                # STOP the user did not ask for can be traced from the journal.
                frames = traceback.extract_stack(limit=6)[:-1]
                path = " <- ".join(f"{f.name}:{f.lineno}" for f in reversed(frames))
                print(f"[agent] STOP sent to ESP32 while moving, from {path}", flush=True)
            self._odo_segment(0, 0)
            self._jog_abort = True
            self._armed = None
            self._send("STOP")
            self._pulsing = False
            if getattr(self, "_motion_fault", None):
                self._last_motion_fault = self._motion_fault
                self._motion_fault = None

    def _pps_ceiling(self) -> int:
        # The LEDC timer is hardware: the drive's own rating is the only limit.
        return self.drive_max_pps

    def abort_jog(self) -> None:
        self._jog_abort = True
        self._send("STOP")

    def jog(self, motor: str, direction: str, amount: int, speed: Optional[float] = None) -> None:
        pulses = max(0, min(SERVO_JOG_MAX_PULSES, int(amount)))
        if pulses == 0:
            return
        if self.motor_index is not None:
            motor = "both"
        elif self.single_motor:
            if motor == "b":
                return
            motor = "both"
        self.engage()
        forward = direction == "down"
        with self._motor_lock:
            self._odo_segment(0, 0)
            self._pulsing = False
            self._jog_abort = False
            self._jog_done.clear()
            self._jog_sent = 0
            self._send(f"JOG {motor} {1 if forward else -1} {pulses} {SERVO_JOG_PPS}")
        # Blocks on the Carousel worker like the GPIO jog; estop sends STOP,
        # the firmware answers JOGDONE with what it managed to send.
        self._jog_done.wait(pulses / float(SERVO_JOG_PPS) + 3.0)
        if motor == "both" and self._jog_sent:
            with self._odo_lock:
                self._odo_close_segment()
                self._odo_pulses += (1 if forward else -1) * self._jog_sent

    def arm_stop(self, sensor: str = "shelf", min_gap_s: float = 0.0) -> None:
        """
        Make the ESP32 cut the pulse train on the next ARRIVAL edge of `sensor`
        ("shelf" or "index"), without waiting for the Pi. The edge still
        arrives in the counters as usual, so the Carousel's own bookkeeping is
        unchanged — only the stop happens earlier. `min_gap_s` is how long the
        window must have been empty before an arrival counts (bounce guard).
        """
        level = 0 if SENSOR_INVERT else 1
        self._armed = sensor
        gap_us = int(max(0.0, float(min_gap_s)) * 1_000_000)
        self._send(f"ARM {'S' if sensor == 'shelf' else 'H'} {level} {gap_us}")

    def disarm(self) -> None:
        if self._armed is not None:
            self._armed = None
            self._send("ARM 0")

    def set_servo_params(self, *args, **kwargs) -> None:
        super().set_servo_params(*args, **kwargs)
        if self._connected:
            self._send_cfg()

    def alarms(self) -> tuple[bool, bool]:
        if self.ignore_alarm:
            return (False, False)
        a, b = self._alarms
        b_used = not (self.single_motor and self.motor_index is None)
        return (bool(a), bool(b and b_used))

    def servo_snapshot(self) -> Optional[dict]:
        snap = super().servo_snapshot() or {}
        with self._state_lock:
            snap.update({
                "driver": "esp32",
                "linkOk": self._connected,
                "link": self.link,
                "port": self._port_in_use or (self.port_setting or None),
                "baud": self.baud,
                "esp32Firmware": self._firmware,
                "linkError": None if self._connected else self._link_error,
                "motionFault": getattr(self, "_motion_fault", None)
                    or getattr(self, "_last_motion_fault", None),
            })
            if self.wifi:
                snap["esp32Host"] = self._net.get("host")
                snap["esp32Wifi"] = self._net.get("state")
                rssi = self._net.get("rssi")
                snap["esp32Rssi"] = int(rssi) if rssi and rssi.lstrip("-").isdigit() else None
                snap["esp32Ip"] = self._net.get("ip")
        return snap

    def _close_motor(self) -> None:
        self._stop_reader.set()
        self._send("STOP")
        self._send("ENA 1")  # leave the drives in their power-up (enabled) state
        if self._reader is not None and self._reader is not threading.current_thread():
            self._reader.join(timeout=1.0)
        self._drop_link("agent shutting down", quiet=True)

    def cleanup(self) -> None:
        try:
            self._close_motor()
        except Exception:
            pass


class SimHardware:
    """
    Pure-software stand-in so you can run/develop the agent without a Pi.
    A background thread advances a simulated position while the motor "runs",
    producing shelf edges and an index edge at position 0.
    """

    def __init__(self, shelves: int, motor_mode: str = "dc") -> None:
        self.shelves = shelves
        # Pretend to be whichever drive the app selected, so the servo panel
        # (jog, alarm lamps) can be exercised without hardware.
        self.motor_mode = motor_mode if motor_mode in ("dc", "servo") else "dc"
        self.pulses_per_rev = SERVO_PULSES_PER_REV
        self.max_pps = SERVO_MAX_PPS
        self.mirror_b = SERVO_MIRROR_B
        self._held = True
        self._pos = 0.0            # continuous position in shelves
        self._dir = 0             # -1, 0, +1
        self._speed = 0.0
        self._lock = threading.Lock()
        # Mirrors RealHardware: counted edges, not levels.
        self._shelf_pulses = 0
        self._index_pulses = 0
        self._shelf_tick = threading.Event()
        self._index_tick = threading.Event()
        # Position 0.0 is a shelf in place, so the window starts ACTIVE. Seeding
        # this True is what stops a phantom pulse being reported at startup.
        self._shelf_was_active = True
        # Mirrors RealHardware's bounce filter state: time of the last COUNTED
        # shelf, used as a lockout after a trigger rather than a wait before one.
        self._last_counted: Optional[float] = None
        self._shelf_settle = 0.0
        self._suppressed_bounces = 0
        # Mirrors RealHardware: current travel, and the travel at the flag's last
        # departure from the sensor window.
        self.travel_direction: Optional[str] = None
        self.flag_exit_direction: Optional[str] = None
        self._running = True
        self._t = threading.Thread(target=self._loop, daemon=True)
        self._t.start()

    # ---- sensor geometry (lock-free; callers already hold the lock) ----
    def _shelf_window_active(self) -> bool:
        """True while a shelf flag is inside the sensor window."""
        return abs(self._pos - round(self._pos)) <= SIM_SENSOR_HALF_WIDTH

    def _index_window_active(self) -> bool:
        return self._shelf_window_active() and int(round(self._pos)) % self.shelves == 0

    def _loop(self) -> None:
        last = time.monotonic()
        while self._running:
            now = time.monotonic()
            dt = now - last
            last = now
            with self._lock:
                if self._dir != 0 and self._speed > 0:
                    # ~1 shelf every (0.4 / speed) seconds.
                    self._pos += self._dir * dt * (self._speed / 0.4)
                # Derive the LEVEL from geometry, then the EDGE from the level —
                # the same order as the real hardware, where gpiozero raises
                # `when_activated` on an inactive->active transition. The old
                # `int(before) != int(pos)` test was a zero-width tripwire: it
                # fired mid-way between shelves and was never active at rest, so
                # a parked-on-sensor carousel was impossible to simulate.
                active = self._shelf_window_active()
                if active and not self._shelf_was_active:
                    # Same post-trigger LOCKOUT as the real hardware: a rising
                    # edge is published immediately unless it is the shelf just
                    # counted rocking back in. Never a wait before the edge.
                    if (self._last_counted is not None
                            and self._shelf_settle > 0
                            and (now - self._last_counted) < self._shelf_settle):
                        self._suppressed_bounces += 1
                    else:
                        self._last_counted = now
                        self._shelf_pulses += 1
                        self._shelf_tick.set()
                    # The INDEX pulse is raised OUTSIDE the bounce filter, on
                    # every rising edge, matching real hardware where the index
                    # sensor is a physically separate input with its own callback.
                    #
                    # Nesting it inside the filter meant a bouncing home flag
                    # suppressed the index pulse as well, so homing could sail
                    # past the home position and time out. Over-counting the index
                    # is harmless (homing only asks "have we seen it yet?"),
                    # whereas missing it loses the datum the whole axis is
                    # referenced from.
                    if self._index_window_active():
                        self._index_pulses += 1
                        self._index_tick.set()
                elif self._shelf_was_active and not active:
                    # Falling edge: the flag has just cleared the window, so the
                    # current travel fixes which side it now rests on. It no
                    # longer feeds the bounce filter, because the filter must not
                    # depend on how long the window has been empty.
                    if self.travel_direction is not None:
                        self.flag_exit_direction = self.travel_direction
                self._shelf_was_active = active
            time.sleep(0.005)

    def forward(self, speed: float) -> None:
        self.engage()
        with self._lock:
            self._dir = +1
            self._speed = speed

    def backward(self, speed: float) -> None:
        self.engage()
        with self._lock:
            self._dir = -1
            self._speed = speed

    def stop(self) -> None:
        with self._lock:
            self._dir = 0
            self._speed = 0.0

    def jog(self, motor: str, direction: str, amount: int, speed: Optional[float] = None) -> None:
        self._jog_abort = False
        self.engage()
        if self.motor_mode == "servo":
            pulses = max(0, min(SERVO_JOG_MAX_PULSES, int(amount)))
            # Take as long as the real bit-banged jog would, and nudge the
            # simulated position by the same fraction of a revolution (one rev
            # ≈ one shelf pitch in this toy model) so the sensor lamp reacts
            # like the real one.
            seconds = pulses / SERVO_JOG_PPS
            delta = pulses / self.pulses_per_rev
        else:
            ms = max(0, min(DC_JOG_MAX_MS, int(amount)))
            duty = DC_JOG_DUTY if speed is None else max(0.0, min(1.0, float(speed)))
            # Same toy model as `_loop`: one shelf every (0.4 / speed) seconds.
            seconds = ms / 1000.0
            delta = seconds * (duty / 0.4)
        deadline = time.monotonic() + seconds
        while time.monotonic() < deadline and not self._jog_abort:
            time.sleep(min(DC_JOG_SLICE_S, max(0.0, deadline - time.monotonic())))
        if motor != "both":
            return  # one chain alone does not move the carousel as a whole
        with self._lock:
            self._pos += delta if direction == "down" else -delta

    _jog_abort = False

    def abort_jog(self) -> None:
        self._jog_abort = True

    def set_servo_params(self, pulses_per_rev=None, max_pps=None, mirror_b=None, **_: object) -> None:
        if pulses_per_rev is not None:
            self.pulses_per_rev = max(1, int(pulses_per_rev))
        if max_pps is not None:
            self.max_pps = max(SERVO_MIN_PPS, min(300_000, int(max_pps)))
        if mirror_b is not None:
            self.mirror_b = bool(mirror_b)

    def __getattr__(self, name: str):
        # The odometer exists only on the servo drive. In DC mode the attribute
        # is absent, exactly as on RealHardware, so the Carousel's
        # `getattr(hw, "pulse_position", None)` probe takes the DC path.
        if name in ("pulse_position", "pulse_rate") and self.__dict__.get("motor_mode") == "servo":
            return self._sim_pulse_position if name == "pulse_position" else self._sim_pulse_rate
        raise AttributeError(name)

    def _sim_pulse_position(self) -> float:
        # Toy model: one motor revolution per shelf pitch, so a carousel
        # revolution calibrates to shelves × pulses_per_rev.
        with self._lock:
            return self._pos * self.pulses_per_rev

    def _sim_pulse_rate(self, speed: float) -> float:
        return max(1.0, (speed / 0.4) * self.pulses_per_rev)

    @property
    def held(self) -> bool:
        return self._held

    def engage(self) -> None:
        if self.motor_mode == "servo" and not self._held:
            time.sleep(SERVO_ENABLE_SETTLE_S)
        self._held = True

    def release(self) -> None:
        if self.motor_mode != "servo":
            raise RuntimeError("Only the servo drive can be released; DC motors are already de-energised when idle.")
        with self._lock:
            self._dir = 0
        self._held = False

    def servo_snapshot(self) -> Optional[dict]:
        if self.motor_mode != "servo":
            return {"type": "servo", "mode": "dc", "mirrorB": self.mirror_b, "jogMaxMs": DC_JOG_MAX_MS}
        return {
            "type": "servo",
            "mode": "servo",
            "alarmA": False,
            "alarmB": False,
            "pulsesPerRev": self.pulses_per_rev,
            "maxPps": self.max_pps,
            "mirrorB": self.mirror_b,
            "held": self._held,
        }

    def set_shelf_settle(self, seconds: float) -> None:
        with self._lock:
            self._shelf_settle = max(0.0, seconds)

    def reset_pulses(self) -> None:
        with self._lock:
            self._shelf_pulses = 0
            self._index_pulses = 0
            # Mirrors RealHardware: clearing the lockout is what stops the
            # previous move's final pulse suppressing the next move's first one.
            self._last_counted = None
        self._shelf_tick.clear()
        self._index_tick.clear()

    def _take(self, kind: str, timeout: float) -> bool:
        tick = self._shelf_tick if kind == "shelf" else self._index_tick
        deadline = time.monotonic() + timeout
        while True:
            with self._lock:
                if kind == "shelf" and self._shelf_pulses > 0:
                    self._shelf_pulses -= 1
                    return True
                if kind == "index" and self._index_pulses > 0:
                    self._index_pulses -= 1
                    return True
            remaining = deadline - time.monotonic()
            if remaining <= 0:
                return False
            tick.clear()
            tick.wait(min(remaining, 0.05))

    def take_shelf_pulse(self, timeout: float) -> bool:
        return self._take("shelf", timeout)

    def take_index_pulse(self, timeout: float) -> bool:
        return self._take("index", timeout)

    def index_clear(self, timeout: float) -> bool:
        deadline = time.monotonic() + timeout
        while self.index_active():
            if time.monotonic() >= deadline:
                return False
            time.sleep(0.005)
        return True

    def index_active(self) -> bool:
        with self._lock:
            return self._index_window_active()

    def shelf_clear(self, timeout: float) -> bool:
        deadline = time.monotonic() + timeout
        while self.shelf_active():
            if time.monotonic() >= deadline:
                return False
            time.sleep(0.005)
        return True

    def shelf_active(self) -> bool:
        with self._lock:
            return self._shelf_window_active()

    def in_shelf_lockout(self) -> bool:
        """Mirror of the real driver's lockout, so both agree on what a bounce is."""
        with self._lock:
            last = self._last_counted
            lockout = self._shelf_settle
            if last is None or lockout <= 0:
                return False
            return (time.monotonic() - last) < lockout

    def cleanup(self) -> None:
        self._running = False
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
