Swede-maker/paternoster-filament-storage/(commit log)

2026-08-14 Uppdaterat filament-system med nya funktioner och kamerastöd
2026-08-18 Fixed Bug
    #Bug. Filament was not registering/Updating the weight when printer was printing while no device was in the browser.
2026-08-19 Add and Bug fix
    Add dual color, add Filament dry reminder tabb, fixed bug with weight add.
2026-08-29 Fixed web UI add QR/RFID
    [esp32-reader.ino, paternoster_agent.py, pi_reader.py, pnpm-lock.yaml]
